dvystrcil/vt350/notes/status.md

# Build status: read this first when picking the project back up

Last updated **2026-11-04**.

## What this printer is

A Voron Trident 350 derivative on a **4040 frame**: MGN12 rails on X/Y, three
MGN9 rails on Z with integrated-leadscrew NEMA17s (T8, 8 mm), 250 mm Z travel,
**MadMax toolchanger** with two toolheads (A4T + Dragon Rapido UHF, Orbiter 2.5
+ **Orbitool O2S** + **Orbiter Smart Filament Sensor**), kinematic bed (LDO
350 plate kit, tanaes Trident mounts), Octopus Pro + Pi 5, fully enclosed.

## Decisions made

| Date | Decision | Where |
|---|---|---|
| 2026-11-10 | **Web front end: Fluidd** (Mainsail stays a one-line switch: `platform/klipper/frontend.py --use mainsail`). Firmware is Kalico; tool-change macros are MadMax's `r2pdx_config-v2-Kalico-Beacon` on klipper-toolchanger | `cad/klipper/README.md`, #116 |
| 2026-11-04 | **+100 mm between the gantry and the frame top**, for bowden/USB clearance; gantry height and Z travel unchanged | `cad/README.md` |
| 2026-11-04 | Frame bars crossing the change are **re-extruded from their end profile** (parametric), not cut-and-spliced | `cad/README.md` |
| 2026-11-04 | Door gets **3 identical hinges** | `cad/README.md` |
| 2026-11-04 | Door handle stays where it is until the pack decision | #5 |
| 2026-11-04 | **Chamber target: 60 °C sustained, 70 °C peak** (revised down from 80 °C). Good for ASA/ABS; some nylons may want more, which is an accepted limit | #4 |
| 2026-11-04 | Active chamber heater; PC/PC-CF printed parts; electronics outside the chamber; motor cooling (all decided at 80 °C: **revisit** at 60 °C) | #4 |
| 2026-11-04 | 140 mm Noctua ceiling fans to push hot air down; **separate insulated roof panel** | #5 |
| 2026-11-04 | Toolheads: **Orbitool O2S + OSS**; **Nitehawk-36 not used** | #6 |
| 2026-11-09 | **lite-30**: O2S + Smart Sensor on both heads (Orbiter designer's STEP, CC0); Nitehawk-36 boxes removed; each Orbiter's motor/gear stack corrected −2.0 mm onto its hub | #6, `cad/README.md` |
| 2026-11-04 | **Go deep: +80 mm of Y at the front** (A4Tv2 + O2S head, deepest slice 68.6 mm). Backbone, Z, bed and rear frame stay; the old front verticals become Z posts | #19, `cad/README.md` (lite-6) |
| 2026-11-04 | Gantry: **LDO Monolith milled, 2WD, VT 9 mm, rear NP** (FT hits the rear gantry 2020); **MGN9 × 470 Y rails**; **Carbonara 430 CF X beam** | #11, #19 |
| 2026-11-04 | **Taller Z: gantry +50 mm in the same 740 mm frame; Z rails and lead screws 400** (~348 mm print height). The 400 integrated motor is in stock at West3D | `cad/README.md` (lite-10) |
| 2026-11-04 | **A4Tv2 needs the 3 mm spacer** between the hotend top and the shroud ceiling (confirmed by the A4Tv2's creator). The nozzle sits 3 mm lower; model it when the A4Tv2 replaces the A4T v1 | #19 |
| 2026-11-05 | **Insulation:** the 3 owned carbon-felt pads (10 mm), sealed in aluminium; roof and back outside their panels, right wall between the panel and the electronics. **Test a pad for conductivity first.** | #14 |
| 2026-11-05 | **Camera: Nocturne USB** (Luke's Lab / West3D, 96°, rated to 70 °C, which is the chamber peak with no margin) inside, top front centre; stream MJPEG (ustreamer): a Pi 5 has no H.264 encoder, and current C920s have none either | #14 |
| 2026-11-05 | **Lights: 24 V warm white, 3500–4000 K, CRI ≥ 90**, COB in aluminium channel, switched from an Octopus output; no 5 V lighting | #14 |
| 2026-11-05 | **Kinematic bed: tanaes's Trident set** (owned, West3D). The model still has his V2.4 parts, with the front pair floating; see `notes/kinematic-bed.md` | #10 |
| 2026-11-04 | **Crossbow: the all-metal (aluminium CNC) version from West3D**, DW-Tas's current design. The A4Tv2 assembly already models it. The older Crossbow in lite-14 and earlier is gone from lite-15 | #12 |
| 2026-11-04 | **A4Tv2: its creator says to modify it as needed.** Licences decide where changes go. The A4Tv2 is [CC BY-NC-SA 4.0](https://github.com/DW-Tas/A4Tv2): remixes are allowed with attribution, non-commercially, under the same licence. The MadMax plate and dock parts are GPL-3.0. The two licences don't mix, so keep any fit changes **on the MadMax plate side (GPL-3.0, like `cad/derived/`)**, and keep any A4Tv2 changes in their own CC BY-NC-SA 4.0 folder. **Correction (lite-15):** the first hole check compared the wrong holes (the extruder mounting pattern). The proper check, in lite-15, finds all three XOL carriage-screw pairs of the A4Tv2 on andrewmcgr's plate, so **the plate fits unmodified**. Open: the left head's Crossbow lever hits the left dock brackets, and the length of the upper carriage screws | #19 |

## Open decisions (blocking)

| Issue | Question |
|---|---|
| #4 | Panel material (polycarbonate vs aluminium/ACM; acrylic is marginal at the 70 °C peak) |
| #5 | **Side pack vs DOOMCube-style top pack** for the electronics; fan model and how the 70 °C peak is bounded at the ceiling (stock NF-A14 is rated to exactly 70 °C) |
| #3 | Bowden + USB routing through the new headroom, and where they exit |
| #11 | 2WD vs AWD: the model mixes both |

## Build stages (in order)

#7 frame order → #8 printed parts → #9 frame assembly → #10 Z + bed →
#11 gantry → #12 toolchanger + toolheads → #13 electronics → #14 enclosure →
#15 first power-on + calibration.

Each stage issue has an **inventory** acceptance criterion. Tick it as you
confirm which parts you already own.

## Where things are

| What | Where |
|---|---|
| Model files (not in git) | `~/Documents/VT350/`. Current working copy **`vt350-lite-22.FCStd`** (lite-19 + the re-measured rear hole row (lite-20), BTT Pad 7 screen removed (lite-21), pad cut-outs measured with calipers (lite-22); electronics in `vt350-ebox.FCStd`, same global frame); untouched original `vt350-good.FCStd` |
| **Backup of the model files** | restic to the home NAS. Run **`cad/backup-models.sh --verify`** (alias `vt350-backup`) after model changes; old snapshots are pruned automatically (last 10, daily for 30 days, monthly for a year). Target and password are local config (`~/.config/vt350/backup.env`), not in this public repo; keep the restic password in the password manager too. First backup 2026-11-04: 52 files, 4.09 GB, test restore byte-identical |
| How the model files were made + how to redo it | `cad/README.md`, `cad/passes/` |
| Cut list (draft) | `notes/cut-list.md` |
| Parts already owned + design impact | `notes/parts-owned.md` |
| Source STEP files (frame variants, toolheads, boards) | `~/Documents/VT350/` |
| FreeCAD | `~/FreeCAD/FreeCAD_26.3rc2-Linux-x86_64.AppImage`, launched from `~/Desktop/freecad-26.3rc2.desktop` (on the RTX 2070) |
| Tracking | GitHub project "3D Printer Projects"; label `build-stage` |

## Not in this repo / not done yet

- The model backup is on the home NAS, which is not off-site.
- `~/Documents/3D Files/ebox/ebox.FCStd` is **not** this printer's ebox (most
  likely the Neptune's portable power supply). The VT350 electronics are the
  `Electronics` group inside the model.
- Splitting the model into per-assembly files with `App::Link` (would make it
  lighter still).
- Klipper config (`config/`): starts in stage #15.
- Wiring documentation for the electronics (stage #13): candidate tool [WireViz](https://github.com/wireviz/WireViz). It turns wiring described in YAML into diagrams and a bill of materials, so the docs can be versioned like the rest of the repo.
