dvystrcil/vt350/notes/reference/frame-colour/fern-low_front.jpg

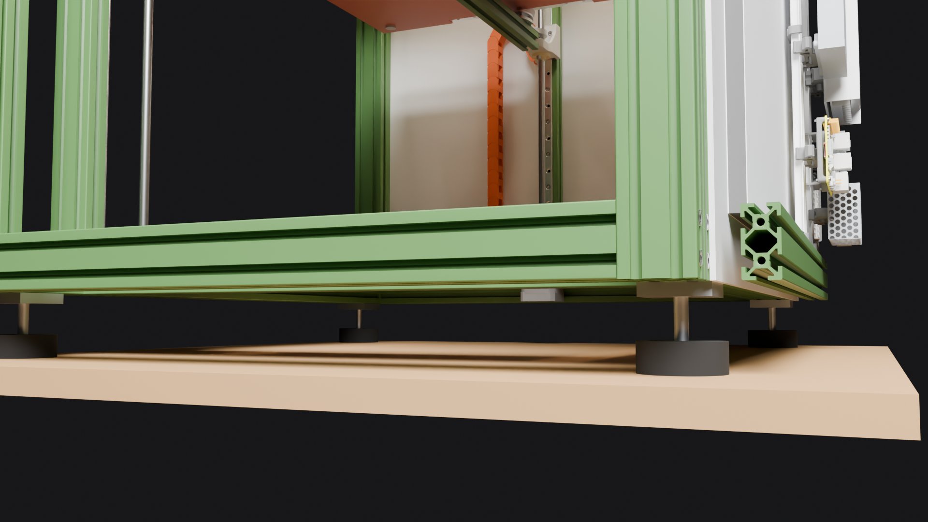
notes/reference/frame-colour/fern-low_front.jpg
