dvystrcil/vt350/notes/reference/frame-colour/fern-low_side.jpg

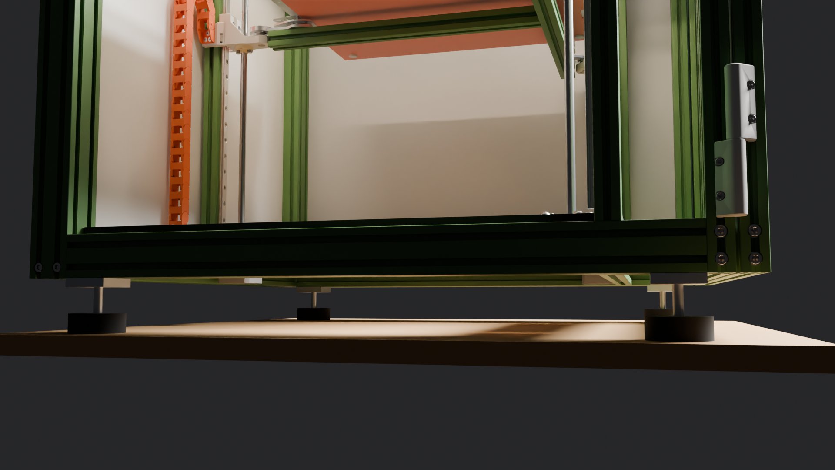
notes/reference/frame-colour/fern-low_side.jpg
