dvystrcil/vt350/notes/reference/frame-colour/r6001-low_side.jpg

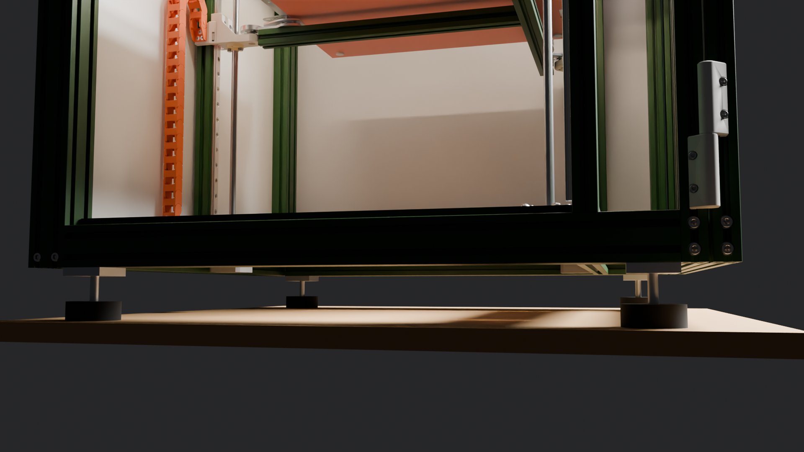
notes/reference/frame-colour/r6001-low_side.jpg
