dvystrcil/vt350/notes/reference/orbiter-hub/1_in_place.jpg

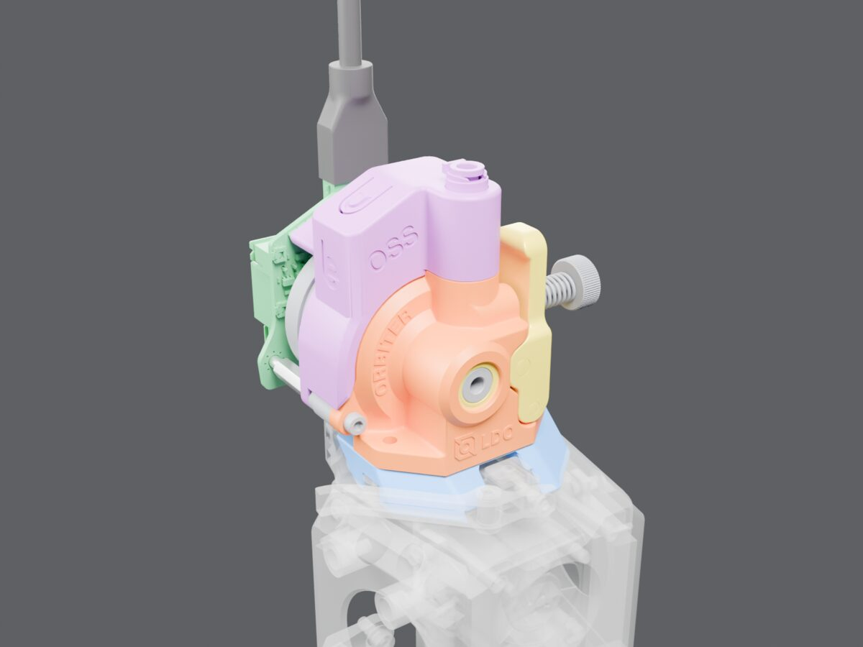
notes/reference/orbiter-hub/1_in_place.jpg
