dvystrcil/vt350/notes/reference/orbiter-hub/2_exploded.jpg

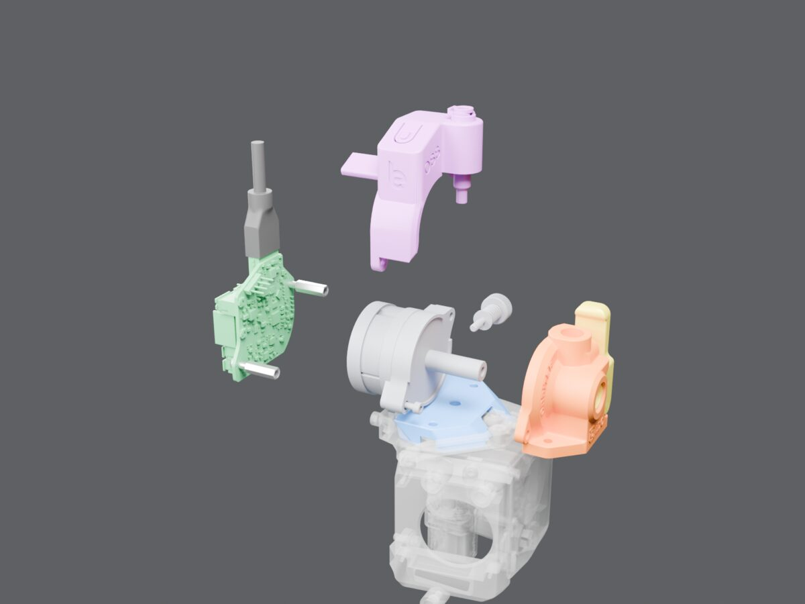
notes/reference/orbiter-hub/2_exploded.jpg
