dvystrcil/vt350/notes/reference/orbiter-hub/3_hub_closeup.jpg

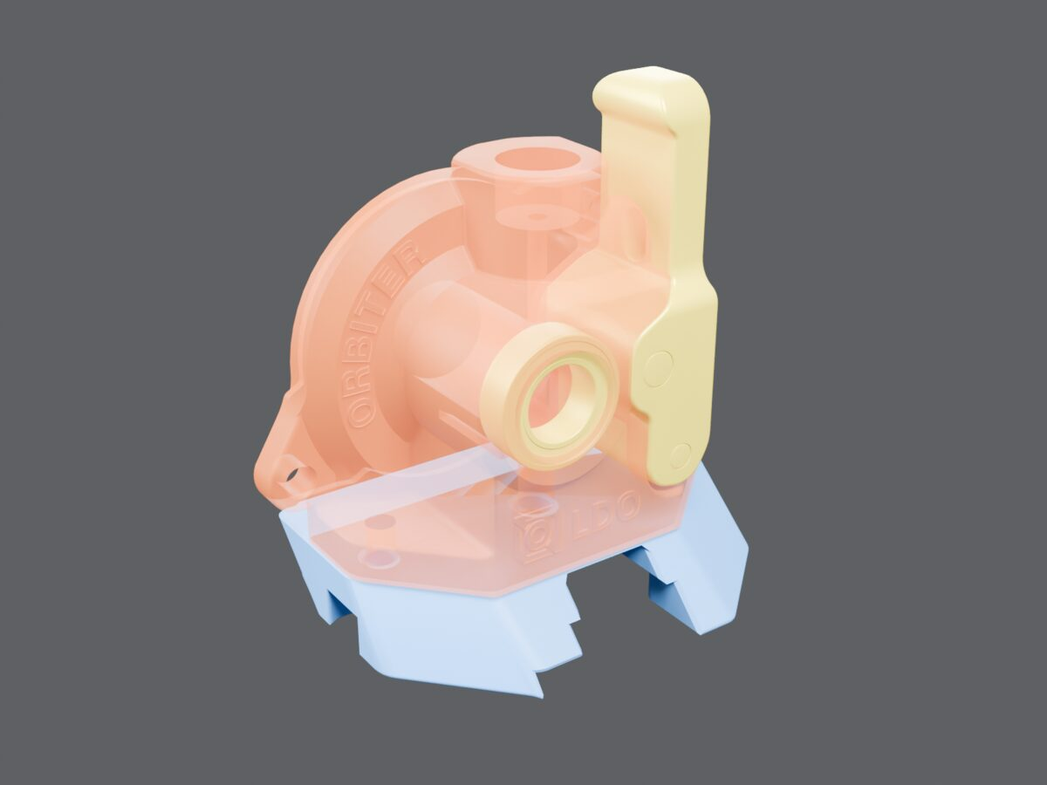
notes/reference/orbiter-hub/3_hub_closeup.jpg
