dvystrcil/vt350/notes/reference/toolchange-docks/1_t0-pickup-seq20.jpg

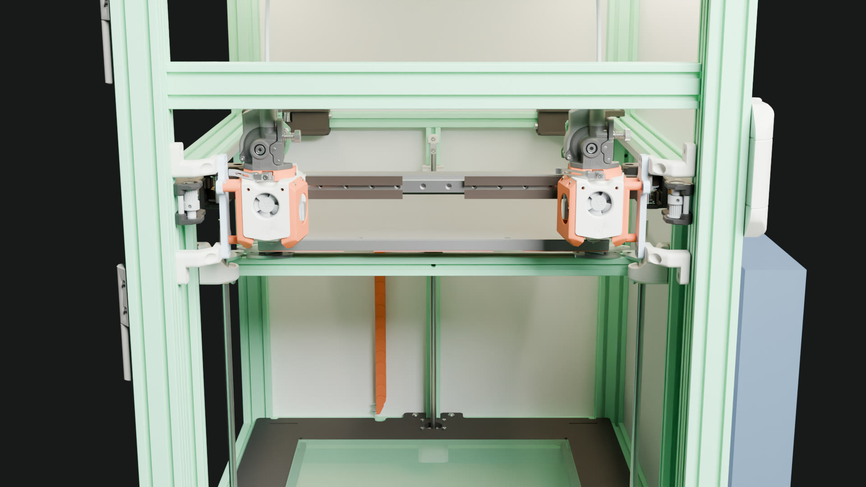
notes/reference/toolchange-docks/1_t0-pickup-seq20.jpg
