dvystrcil/vt350/parts/printed/manifest.csv

path | part | qty | stage | bom | source | repo | commit | upstream_path | sha256 | license | variant | link | material | notes
voron-trident/z_carriage_left.stl | Z carriage, left | 1 | 10 | Z_Assembly/z_carriage_left/right, [a]_z_carriage_left/right | Voron Trident R1 | VoronDesign/Voron-Trident | 86eae85057df4e3d1a07fe7eae44d6126724fe00 | STLs/Z_Assembly/z_carriage_left.stl | 81a21244a3c9f269a8c3c8a4f679dc732e6a184795a4f4e1b7f535c1d6719d2f | GPL-3.0 |  |  | chamber material (#8 AC1)
voron-trident/z_carriage_right.stl | Z carriage, right | 1 | 10 | Z_Assembly/z_carriage_left/right, [a]_z_carriage_left/right | Voron Trident R1 | VoronDesign/Voron-Trident | 86eae85057df4e3d1a07fe7eae44d6126724fe00 | STLs/Z_Assembly/z_carriage_right.stl | c2fd3f513c2ecfd7a1eec1b6bf36ac21b913ee49b1320579de19448d189f0bf1 | GPL-3.0 |  |  | chamber material (#8 AC1)
voron-trident/[a]_z_carriage_left.stl | Z carriage cover, left | 1 | 10 | Z_Assembly/z_carriage_left/right, [a]_z_carriage_left/right | Voron Trident R1 | VoronDesign/Voron-Trident | 86eae85057df4e3d1a07fe7eae44d6126724fe00 | STLs/Z_Assembly/[a]_z_carriage_left.stl | 0ee600fee7b37519e4b7689d9658e6ef2d71baa492f395a0afc1b8cb54ac64f0 | GPL-3.0 |  |  | chamber material (#8 AC1) | accent colour
voron-trident/[a]_z_carriage_right.stl | Z carriage cover, right | 1 | 10 | Z_Assembly/z_carriage_left/right, [a]_z_carriage_left/right | Voron Trident R1 | VoronDesign/Voron-Trident | 86eae85057df4e3d1a07fe7eae44d6126724fe00 | STLs/Z_Assembly/[a]_z_carriage_right.stl | e75dc5a149c4daa41c57ed505795e29d18de8bc0dd60e327afca741d4891c497 | GPL-3.0 |  |  | chamber material (#8 AC1) | accent colour
voron-trident/z_carriage_rear_2hole.stl | Z carriage, rear (2-hole chain mount) | 1 | 10 | Z_Assembly/z_carriage_rear_2hole or _3hole | Voron Trident R1 | VoronDesign/Voron-Trident | 86eae85057df4e3d1a07fe7eae44d6126724fe00 | STLs/Z_Assembly/z_carriage_rear_2hole.stl | 55990b0ba031a994f0fdc5109acb678de8c9fc44f7211c8c50861ef639529662 | GPL-3.0 | z-rear-carriage |  | chamber material (#8 AC1) | pick 2-hole or 3-hole to match the Z chain (decide, #10 AC4)
voron-trident/z_carriage_rear_3hole.stl | Z carriage, rear (3-hole chain mount) | 1 | 10 | Z_Assembly/z_carriage_rear_2hole or _3hole | Voron Trident R1 | VoronDesign/Voron-Trident | 86eae85057df4e3d1a07fe7eae44d6126724fe00 | STLs/Z_Assembly/z_carriage_rear_3hole.stl | d807725cff29aef0bf7916b9425bed76358725fab5055f5ce4e1a420d1c5eed5 | GPL-3.0 | z-rear-carriage |  | chamber material (#8 AC1) | pick 2-hole or 3-hole to match the Z chain (decide, #10 AC4)
voron-trident/[a]_z_rail_stop_x3.stl | Z rail stop | 3 | 10 | Z_Assembly/[a]_z_rail_stop_x3 | Voron Trident R1 | VoronDesign/Voron-Trident | 86eae85057df4e3d1a07fe7eae44d6126724fe00 | STLs/Z_Assembly/[a]_z_rail_stop_x3.stl | 7f3ac04062f2157999bc1e272c30512186d79f4d0beea98f3b561361f81e745f | GPL-3.0 |  |  | chamber material (#8 AC1) | accent colour
voron-trident/z_rear_extrusionbracket_left.stl | Z rear extrusion bracket, left | 1 | 10 | Z_Assembly/z_rear_extrusionbracket_left/right | Voron Trident R1 | VoronDesign/Voron-Trident | 86eae85057df4e3d1a07fe7eae44d6126724fe00 | STLs/Z_Assembly/z_rear_extrusionbracket_left.stl | c41999d78519b8dc876528f42b831bfefe86a3eaebb01540eaa775d01e120d8d | GPL-3.0 |  |  | chamber material (#8 AC1) | Monolith FAQ: rotate 180° in Full Travel mode, or plain brackets in No Protrusion mode
voron-trident/z_rear_extrusionbracket_right.stl | Z rear extrusion bracket, right | 1 | 10 | Z_Assembly/z_rear_extrusionbracket_left/right | Voron Trident R1 | VoronDesign/Voron-Trident | 86eae85057df4e3d1a07fe7eae44d6126724fe00 | STLs/Z_Assembly/z_rear_extrusionbracket_right.stl | 4c6d388cbd160d20cf52bfd7b9840c1769e1be1e2be4674368cdcb4425ae7a3f | GPL-3.0 |  |  | chamber material (#8 AC1) | Monolith FAQ: rotate 180° in Full Travel mode, or plain brackets in No Protrusion mode
voron-trident/10mm_extrusion_drill_guide.stl | Extrusion drill guide, 10 mm | 1 | 9 | Tools/10mm_extrusion_drill_guide, 140mm_extrusion_drill_guide | Voron Trident R1 | VoronDesign/Voron-Trident | 86eae85057df4e3d1a07fe7eae44d6126724fe00 | STLs/Tools/10mm_extrusion_drill_guide.stl | f30f3b0421c79b6f254c1c5f8020dcc1e69b2d147da14fd3a45785bbacabc81e | GPL-3.0 |  |  | any material (assembly jig)
voron-trident/140mm_extrusion_drill_guide.stl | Extrusion drill guide, 140 mm | 1 | 9 | Tools/10mm_extrusion_drill_guide, 140mm_extrusion_drill_guide | Voron Trident R1 | VoronDesign/Voron-Trident | 86eae85057df4e3d1a07fe7eae44d6126724fe00 | STLs/Tools/140mm_extrusion_drill_guide.stl | 453660ff6ab57c3445951c77f0ade78f5d8e1d9aad4b93afc7c9b4f1b1387fea | GPL-3.0 |  |  | any material (assembly jig)
voron-trident/MGN9_rail_guide_x2.stl | MGN9 rail guide (Z and Y rails) | 2 | 10 | Tools/MGN9_rail_guide_x2, MGN12_rail_guide_x2 | Voron Trident R1 | VoronDesign/Voron-Trident | 86eae85057df4e3d1a07fe7eae44d6126724fe00 | STLs/Tools/MGN9_rail_guide_x2.stl | bbd4cf6fc1ef3d50a0e1faacc7b5123db79ff4b8ce31f31d677df95bf49dad8d | GPL-3.0 |  |  | any material (assembly jig) | also used for the Y rails in #11
voron-trident/MGN12_rail_guide_x2.stl | MGN12 rail guide (X rail) | 2 | 11 | Tools/MGN9_rail_guide_x2, MGN12_rail_guide_x2 | Voron Trident R1 | VoronDesign/Voron-Trident | 86eae85057df4e3d1a07fe7eae44d6126724fe00 | STLs/Tools/MGN12_rail_guide_x2.stl | d56bd9b521475499ea27796228a147a4291014329d2b168abb548d686773212a | GPL-3.0 |  |  | any material (assembly jig)
ldo-monolith/Cable_management_clip_S.stl | Cable management clip, S | as-needed | 11 | LDO Monolith kit STLs | LDO Monolith kit | Monolith3D/LDO_Monolith_Gantry_Kits | 95cb5fc3957369aeb1e631f4656880bdb69ea770 | STLs/Cable_management/Cable_management_clip_S.stl | 32494dd8836d94a9dda2d26cb8de5dd0e37413373f4ed947656710a6de4614df | CC BY-NC-SA 4.0 |  |  | chamber material (#8 AC1) | quantity per the LDO manual (not stated in the repo)
ldo-monolith/Cable_management_clip_M.stl | Cable management clip, M | as-needed | 11 | LDO Monolith kit STLs | LDO Monolith kit | Monolith3D/LDO_Monolith_Gantry_Kits | 95cb5fc3957369aeb1e631f4656880bdb69ea770 | STLs/Cable_management/Cable_management_clip_M.stl | 686feace5ce71dd7da42a3276fc0d85e44de4b0c1a0d32f02f87619d942c3e18 | CC BY-NC-SA 4.0 |  |  | chamber material (#8 AC1) | quantity per the LDO manual (not stated in the repo)
ldo-monolith/Cable_management_clip_L.stl | Cable management clip, L | as-needed | 11 | LDO Monolith kit STLs | LDO Monolith kit | Monolith3D/LDO_Monolith_Gantry_Kits | 95cb5fc3957369aeb1e631f4656880bdb69ea770 | STLs/Cable_management/Cable_management_clip_L.stl | ac743b804461715d961a5531efddb836328132bf2483abc2afc7e07f6d725ef1 | CC BY-NC-SA 4.0 |  |  | chamber material (#8 AC1) | quantity per the LDO manual (not stated in the repo)
madmax/SpeedClip_4mm_Gap_9mm.stl | MadMax SpeedClip, 9 mm belts | 2 | 11 | Gantry/X_Axis/X_Carriage/* | MadMax | zruncho3d/madmax | 6bf670de9adcc5924e2fb552978161d7a9c7b1c8 | STL/SpeedClip_4mm_Gap_9mm.stl | 10d362376dc9f0ce39810f838bdd0216ccf31f945adddc696575c604f00b1b77 | GPL-3.0 |  |  | chamber material (#8 AC1)
madmax/andrewmcgr/Plate Assembly.stl | MadMax tool plate (XOL), one per head | 2 | 12 | MadMax | MadMax / andrewmcgr | zruncho3d/madmax | 6bf670de9adcc5924e2fb552978161d7a9c7b1c8 | User Mods/andrewmcgr/XOL-A4T-Cartographer/STL/Plate Assembly.stl | bf427c0e4f2fa7dfc713b465c190908d05d30d3804efeab0b01f223cd8c2d5ce | GPL-3.0 |  |  | chamber material (#8 AC1)
madmax/andrewmcgr/Plate Back.stl | MadMax tool plate back, one per head | 2 | 12 | MadMax | MadMax / andrewmcgr | zruncho3d/madmax | 6bf670de9adcc5924e2fb552978161d7a9c7b1c8 | User Mods/andrewmcgr/XOL-A4T-Cartographer/STL/Plate Back.stl | f2923ed46711539a90301a58d00a8e6f91972312301459e56eebe451b1b6fdee | GPL-3.0 |  |  | chamber material (#8 AC1)
madmax/andrewmcgr/Dock Asembly.stl | MadMax dock keyslot plate, one per dock | 2 | 12 | MadMax | MadMax / andrewmcgr | zruncho3d/madmax | 6bf670de9adcc5924e2fb552978161d7a9c7b1c8 | User Mods/andrewmcgr/XOL-A4T-Cartographer/STL/Dock Asembly.stl | 7660f9bdbe89f2e9a5c8615ff76f67651c1059c46eeaa4c9ddd0e3aa4fa6c983 | GPL-3.0 |  |  | chamber material (#8 AC1) | upstream spelling 'Asembly'
a4tv2/main-body_dragon-rapido-UHF_o2_xol.stl | A4Tv2 main body (Dragon Rapido UHF, Orbiter, XOL) | 2 | 12 | A4Tv2 | A4Tv2 | DW-Tas/A4Tv2 | 888755a97da9e1bd3062c35c914538342ef7d6f2 | STL/main_bodies/main-body_dragon-rapido-UHF_o2_xol.stl | bf1bb79c9b672eca807577d7e6f5ae64e64bb99a685265c99c1ceb4f4e2da979 | CC BY-NC-SA 4.0 |  |  | chamber material (#8 AC1)
a4tv2/[a]_orbiter-crossbow-adapter_o2_xol.stl | A4Tv2 Orbiter Crossbow adapter | 2 | 12 | A4Tv2 | A4Tv2 | DW-Tas/A4Tv2 | 888755a97da9e1bd3062c35c914538342ef7d6f2 | STL/extruder_adapters/[a]_orbiter-crossbow-adapter_o2_xol.stl | 7f25811caab55fb5dcf97d61d496cd425d741a80edac535b55f87d7d2ae03fe3 | CC BY-NC-SA 4.0 |  |  | chamber material (#8 AC1) | accent colour
a4tv2/Duct-HEF-Dragon-UHF.stl | A4Tv2 hotend-fan duct (Dragon UHF, 2510) | 2 | 12 | A4Tv2 | A4Tv2 | DW-Tas/A4Tv2 | 888755a97da9e1bd3062c35c914538342ef7d6f2 | STL/ducts/Duct-HEF-Dragon-UHF.stl | aaf80a56f96de0005d8d0da980f1046dd384f7493d45506eefe22e362d1d9110 | CC BY-NC-SA 4.0 |  |  | chamber material (#8 AC1)
a4tv2/LED_Carrier.stl | A4Tv2 LED carrier | 2 | 12 | A4Tv2 | A4Tv2 | DW-Tas/A4Tv2 | 888755a97da9e1bd3062c35c914538342ef7d6f2 | STL/led_carrier/LED_Carrier.stl | 9bc0fea88593759ee115b19a287982673e309cb9476108f99dfa0104207d99c9 | CC BY-NC-SA 4.0 |  |  | chamber material (#8 AC1)
a4tv2/[t]_LED_diffuser.stl | A4Tv2 LED diffuser | 2 | 12 | A4Tv2 | A4Tv2 | DW-Tas/A4Tv2 | 888755a97da9e1bd3062c35c914538342ef7d6f2 | STL/led_carrier/[t]_LED_diffuser.stl | e7dfcb37d65752520259b39a1312694ce6a705809ea01204765f21ee488f455e | CC BY-NC-SA 4.0 |  |  | chamber material (#8 AC1) | transparent filament ([t])
clicky-clack/Hinge-L-solid-2X.stl | Door hinge, solid part | 3 | 9 | Clicky-Clack fridge door (tanaes) | Clicky-Clack door | tanaes/whopping_Voron_mods | 62268ed817878e54d6a1186882060aa8368d4f0f | clickyclacky_door/STLs/Hinge-L-solid-2X.stl | d597ec8fda60f70a4c5c062f1cd2616dc169451abc6503c98c0487563937924d | GPL-3.0 |  |  | chamber material (#8 AC1) | ×3 for 3 hinges (upstream ships ×2)
clicky-clack/Hinge-L-sleeve-2X.stl | Door hinge, sleeve part | 3 | 9 | Clicky-Clack fridge door (tanaes) | Clicky-Clack door | tanaes/whopping_Voron_mods | 62268ed817878e54d6a1186882060aa8368d4f0f | clickyclacky_door/STLs/Hinge-L-sleeve-2X.stl | a052bb029f5758da2552417accdee0df6e23d63e6c597824625902a86340f32b | GPL-3.0 |  |  | chamber material (#8 AC1) | ×3 for 3 hinges (upstream ships ×2)
clicky-clack/Handle.stl | Door handle | 1 | 14 | Clicky-Clack fridge door (tanaes) | Clicky-Clack door | tanaes/whopping_Voron_mods | 62268ed817878e54d6a1186882060aa8368d4f0f | clickyclacky_door/STLs/Handle.stl | a2f596a1e2c64dffd3f80d2cc12171ee723ebad4b84bd4c76b107a6a2fcd0d34 | GPL-3.0 |  |  | chamber material (#8 AC1)
clicky-clack/Handle-Hinge_Top.stl | Door handle hinge, top | 1 | 14 | Clicky-Clack fridge door (tanaes) | Clicky-Clack door | tanaes/whopping_Voron_mods | 62268ed817878e54d6a1186882060aa8368d4f0f | clickyclacky_door/STLs/Handle-Hinge_Top.stl | 772ad3170575dbc6e4a1f8ef6c09c45dcd14294cd52626bd19286c2e7a8f4017 | GPL-3.0 |  |  | chamber material (#8 AC1)
clicky-clack/Handle-Hinge_Bottom.stl | Door handle hinge, bottom | 1 | 14 | Clicky-Clack fridge door (tanaes) | Clicky-Clack door | tanaes/whopping_Voron_mods | 62268ed817878e54d6a1186882060aa8368d4f0f | clickyclacky_door/STLs/Handle-Hinge_Bottom.stl | cbbb4667ca3e0c441e44c18c1c9099725028111d7f86436126764d0672c361e6 | GPL-3.0 |  |  | chamber material (#8 AC1)
clicky-clack/Latch.stl | Door latch | 1 | 14 | Clicky-Clack fridge door (tanaes) | Clicky-Clack door | tanaes/whopping_Voron_mods | 62268ed817878e54d6a1186882060aa8368d4f0f | clickyclacky_door/STLs/Latch.stl | 52aff26fe7d564f4b88791b5868cc04250f3131708a40dbc1cc4ec53261e7ca7 | GPL-3.0 |  |  | chamber material (#8 AC1)
clicky-clack/Panel_Clip.stl | Door panel clip | 1 | 14 | Clicky-Clack fridge door (tanaes) | Clicky-Clack door | tanaes/whopping_Voron_mods | 62268ed817878e54d6a1186882060aa8368d4f0f | clickyclacky_door/STLs/Panel_Clip.stl | 818d4f975891d1d4c372d1d8ae824266a056b450e219ae3ce71a2a656ff54f4c | GPL-3.0 |  |  | chamber material (#8 AC1)
 | EMU (filament unit, per lane) | as-needed | 15 | EMU | EMU | DW-Tas/EMU | 0e92ca241eb2627fab224660ef5925ee872ad0e3 |  |  | CC BY-NC-SA 4.0 |  | https://github.com/DW-Tas/EMU/tree/0e92ca241eb2627fab224660ef5925ee872ad0e3 |  | link only: parts come from EMU's own configurator and are tracked separately (#8 AC2); stage not set by any stage issue yet
vt350/madmax-andrewmcgr-carriage-beacon/MadMaxCarriage Beacon RevH pocket 9mm belts.stl | MadMax carriage, Beacon RevH pocket, 9 mm belts | 1 | 11 | Gantry/X_Axis/X_Carriage/* | vt350 remix | dvystrcil/vt350 | 88dd58e996e1f15d52dc2c0e17e67b3916b837ef | cad/derived/madmax-andrewmcgr-carriage-beacon/MadMaxCarriage Beacon RevH pocket 9mm belts.stl | faf503fc086931be40b6288263381fd2467055347f88f49ee0171dac0efa4bba | GPL-3.0 |  |  | chamber material (#8 AC1) | lite-25 (#58, PR #62); from andrewmcgr's MadMaxCarriage @6bf670d
vt350/madmax-andrewmcgr-dock-arm/Dock Arm -9.06mm.stl | MadMax dock arm, −9.06 mm | 4 | 12 | MadMax | vt350 remix | dvystrcil/vt350 | 7200b3ec192bf8a4debbf67df053c4b717d84d65 | cad/derived/madmax-andrewmcgr-dock-arm/Dock Arm -9.06mm.stl | 790882c3ef472ba29d2c67861647535e56b99847e6610dfdfdbe918248b03472 | GPL-3.0 |  |  | chamber material (#8 AC1) | lite-23 (#53); a top and a bottom arm per dock, right dock = same part turned round
vt350/a4tv2-duct-4010-madmax-dock/A4Tv2 Duct-4010-left MadMax dock.stl | A4Tv2 4010 duct with dock bosses, left | 2 | 12 | A4Tv2 | vt350 remix | dvystrcil/vt350 | 7200b3ec192bf8a4debbf67df053c4b717d84d65 | cad/derived/a4tv2-duct-4010-madmax-dock/A4Tv2 Duct-4010-left MadMax dock.stl | ed1d46c463df9c1656b3d22e0f2e2d28a19adeed11ac18f25c3f0a82053a1e2d | CC BY-NC-SA 4.0 |  |  | chamber material (#8 AC1) | lite-23 (#53); one per head. NOT YET PRINT-ORIENTED: don't print until #53 AC8 picks the orientation
vt350/a4tv2-duct-4010-madmax-dock/A4Tv2 Duct-4010-right MadMax dock.stl | A4Tv2 4010 duct with dock bosses, right | 2 | 12 | A4Tv2 | vt350 remix | dvystrcil/vt350 | 7200b3ec192bf8a4debbf67df053c4b717d84d65 | cad/derived/a4tv2-duct-4010-madmax-dock/A4Tv2 Duct-4010-right MadMax dock.stl | 67dc9f723b268da625f642f0878f4b22d66d8e95f273ffbc44b668c1ac273339 | CC BY-NC-SA 4.0 |  |  | chamber material (#8 AC1) | lite-23 (#53); one per head. NOT YET PRINT-ORIENTED: don't print until #53 AC8 picks the orientation
vt350/btt5160-base-4-middle-screws/btt5160-base-4-middle-screws.stl | BTT TMC5160T Plus base (4 middle screws) | 1 | 13 | vt350 (this repo) | vt350 remix | dvystrcil/vt350 |  |  | a708516e533f7e82961568937cd55126432395a0a28a0b936eaef5595e50149d | GPL-3.0-or-later |  |  | electronics bay: material per #4/#5 | the user's own design (Fusion 360, 2026-05-16), not from a lite-N model; STEP source beside it; check how many drivers one base holds
