dvystrcil/vt350/parts/printed/a4tv2/main-body_dragon-rapido-UHF_o2_xol.stl

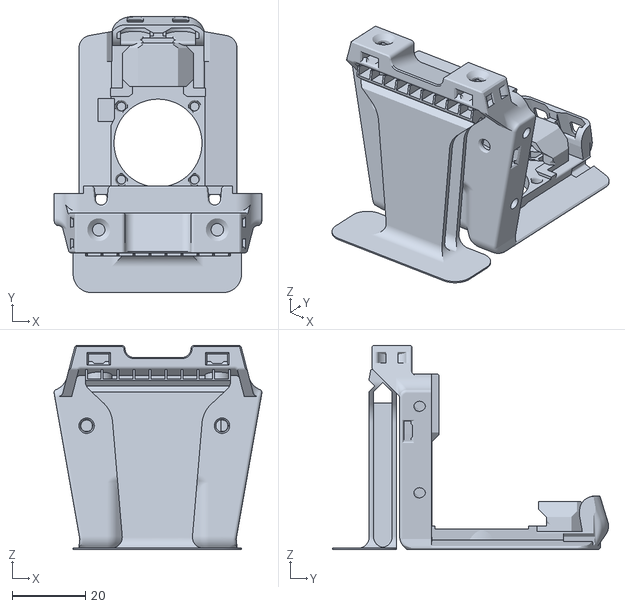
[picture p10: CAD file, 2026-11-06]
parts/printed/a4tv2/main-body_dragon-rapido-UHF_o2_xol.stl
56.8 x 75.4 x 55.8
