dvystrcil/vt350/parts/printed/madmax/andrewmcgr/Plate Assembly.stl

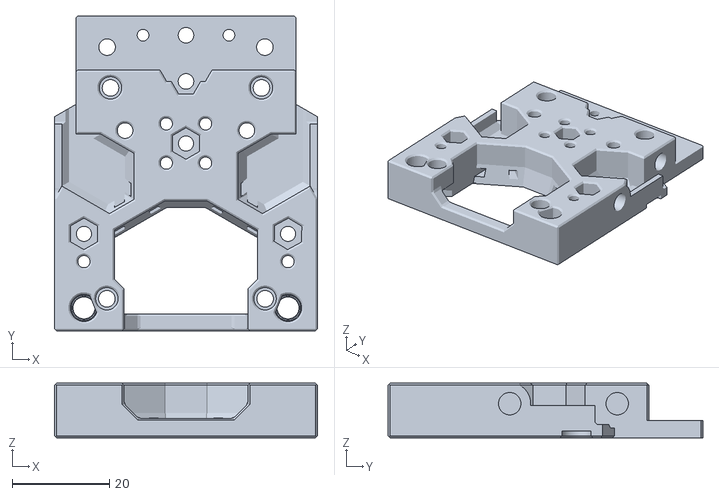
[picture p11: CAD file, 2026-11-06]
parts/printed/madmax/andrewmcgr/Plate Assembly.stl
54.0 x 64.6 x 11.2
