dvystrcil/vt350/cad/derived/madmax-andrewmcgr-carriage-beacon/MadMaxCarriage Beacon RevH pocket.stl

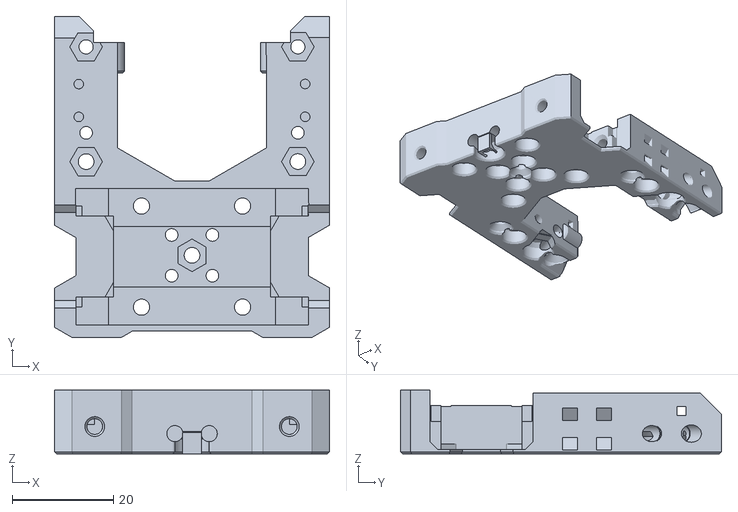
[picture p12: CAD file, 2026-11-06]
cad/derived/madmax-andrewmcgr-carriage-beacon/MadMaxCarriage Beacon RevH pocket.stl
54.4 x 63.5 x 12.6
