dvystrcil/vt350/cad/derived/madmax-andrewmcgr-dock-arm/Dock Arm +5mm.stl

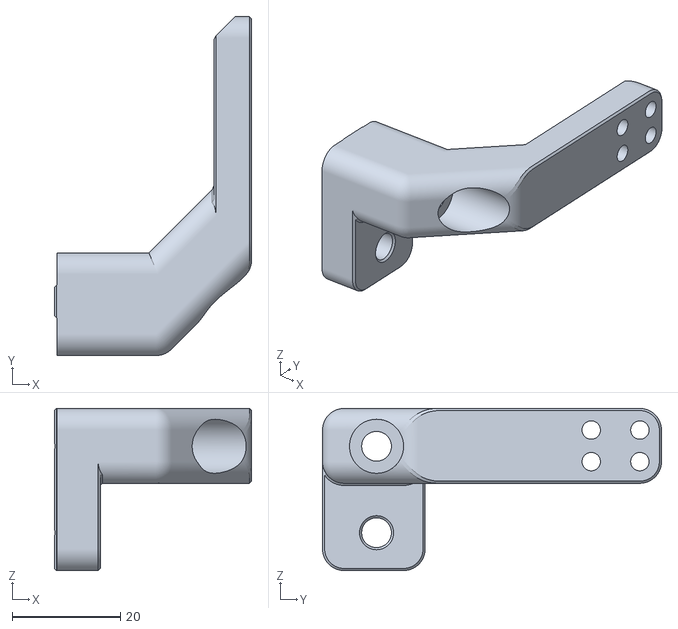
[picture p13: CAD file, 2026-11-05]
cad/derived/madmax-andrewmcgr-dock-arm/Dock Arm +5mm.stl
36.5 x 62.7 x 30.0
