dvystrcil/vt350/parts/printed/a4tv2/[t]_LED_diffuser.stl

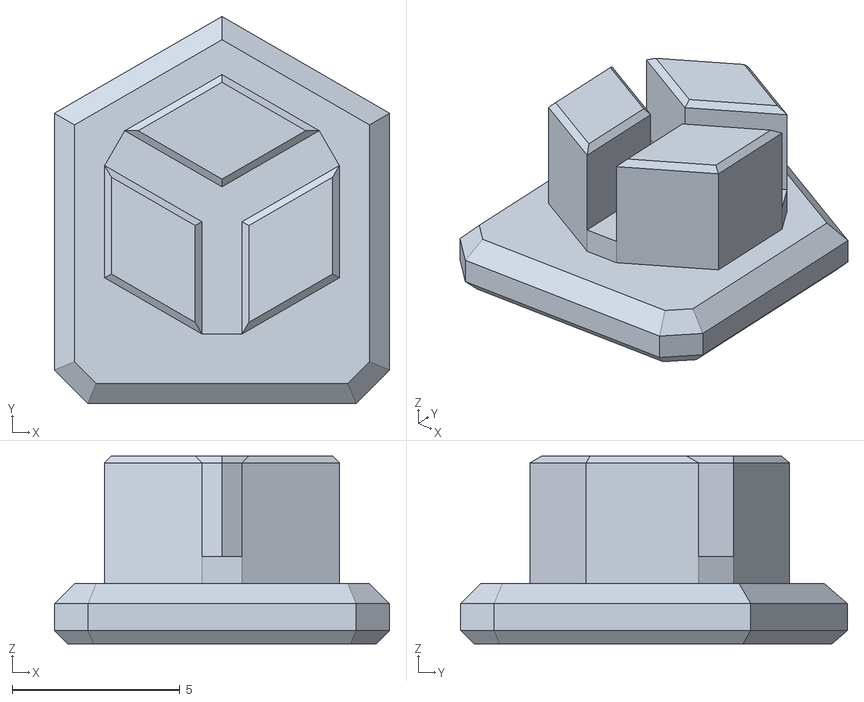
[picture p14: CAD file, 2026-11-06]
parts/printed/a4tv2/[t]_LED_diffuser.stl
10.0 x 11.5 x 5.60
