dvystrcil/vt350/parts/printed/clicky-clack/Handle.stl

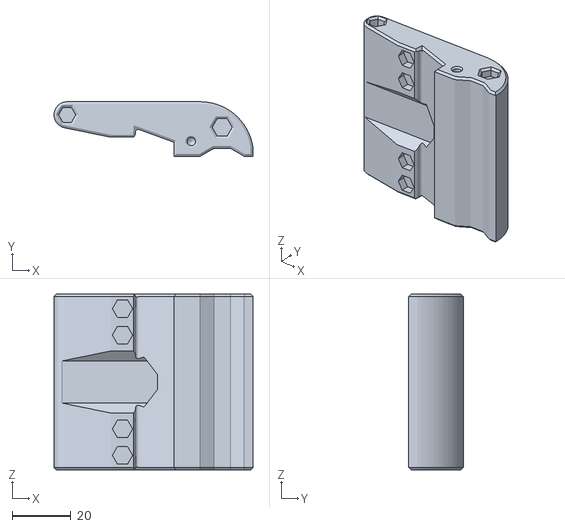
[picture p15: CAD file, 2026-11-06]
parts/printed/clicky-clack/Handle.stl
67.9 x 18.6 x 60.0
