dvystrcil/vt350/parts/printed/ldo-monolith/Cable_management_clip_S.stl

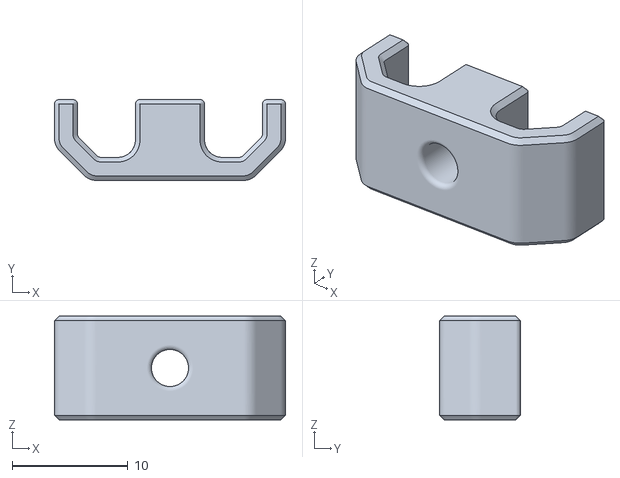
[picture p16: CAD file, 2026-11-06]
parts/printed/ldo-monolith/Cable_management_clip_S.stl
20.0 x 7.00 x 9.00
