dvystrcil/vt350/parts/printed/madmax/andrewmcgr/Dock Asembly.stl

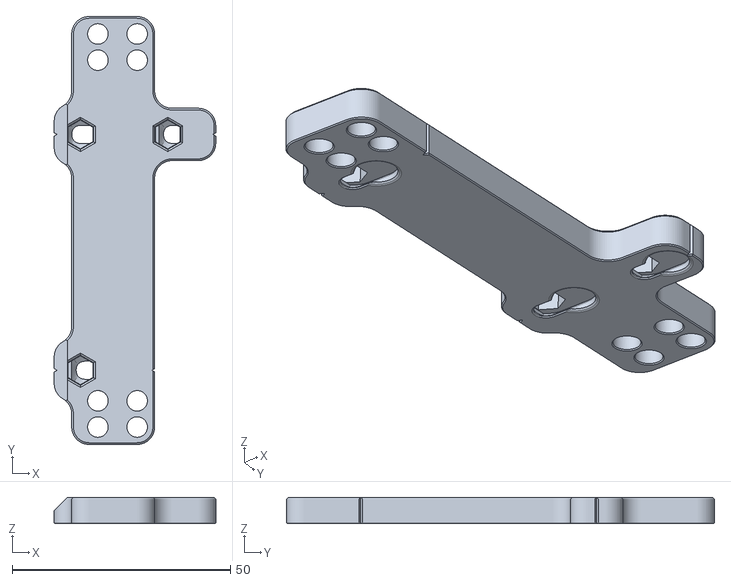
[picture p17: CAD file, 2026-11-06]
parts/printed/madmax/andrewmcgr/Dock Asembly.stl
37.0 x 98.0 x 6.00
