dvystrcil/vt350/parts/printed/madmax/SpeedClip_4mm_Gap_9mm.stl

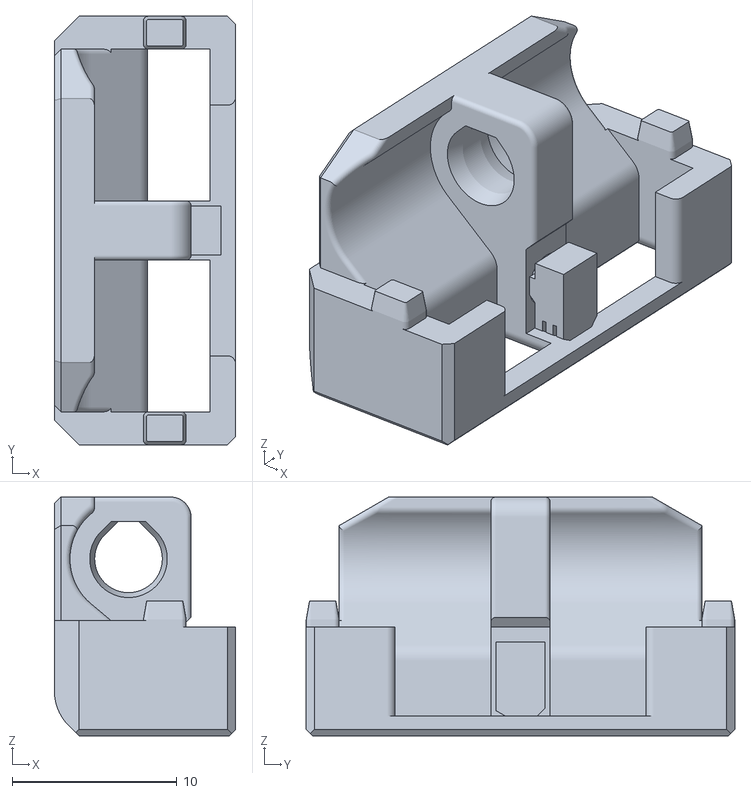
[picture p18: CAD file, 2026-11-06]
parts/printed/madmax/SpeedClip_4mm_Gap_9mm.stl
11.0 x 26.0 x 14.5
