dvystrcil/vt350/parts/printed/voron-trident/z_rear_extrusionbracket_right.stl

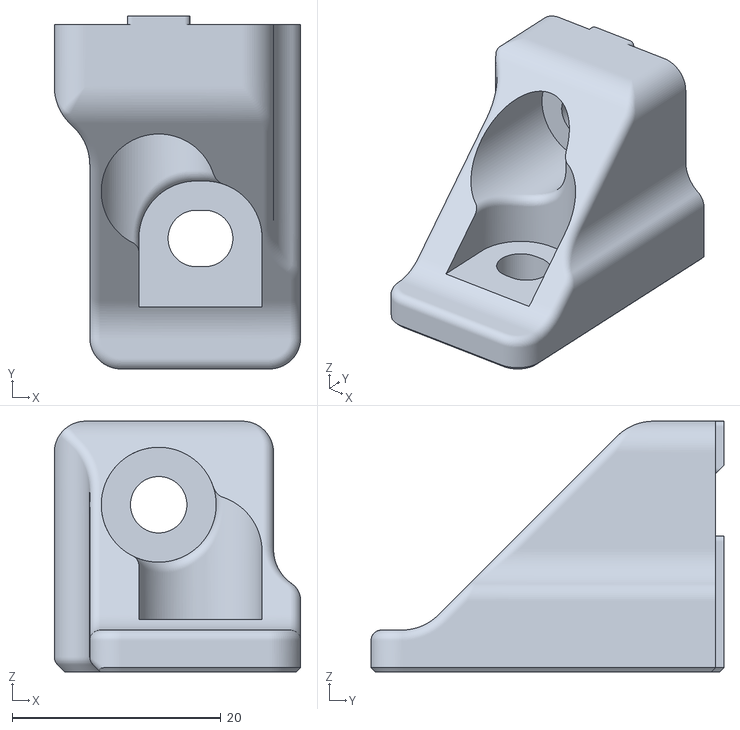
[picture p19: CAD file, 2026-11-06]
parts/printed/voron-trident/z_rear_extrusionbracket_right.stl
23.6 x 33.8 x 24.0
