dvystrcil/vt350/parts/printed/vt350/a4tv2-duct-4010-madmax-dock/A4Tv2 Duct-4010-left MadMax dock.stl

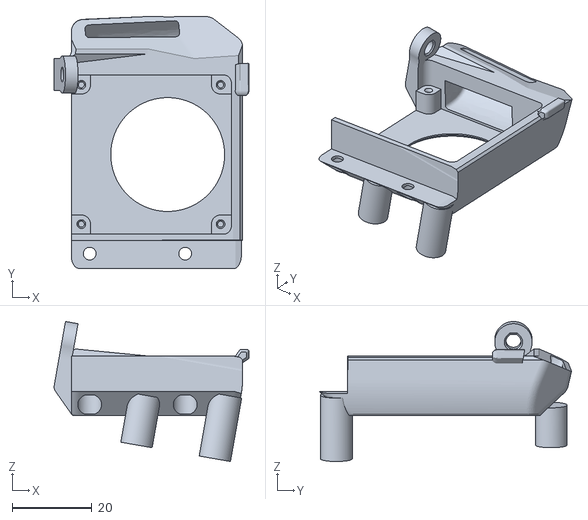
[picture p20: CAD file, 2026-11-06]
parts/printed/vt350/a4tv2-duct-4010-madmax-dock/A4Tv2 Duct-4010-left MadMax dock.stl
49.0 x 63.3 x 35.2
