dvystrcil/vt350/parts/printed/vt350/madmax-andrewmcgr-dock-arm/Dock Arm -9.06mm.stl

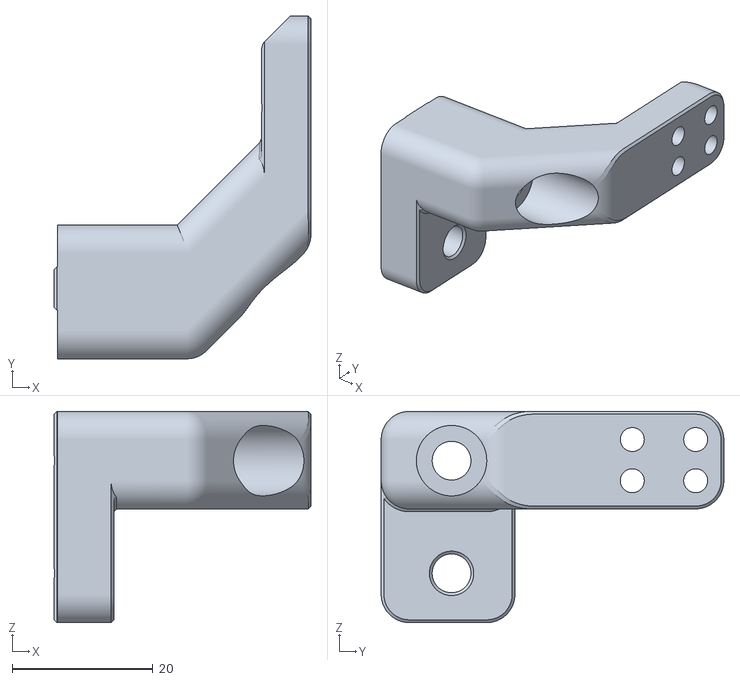
[picture p21: CAD file, 2026-11-06]
parts/printed/vt350/madmax-andrewmcgr-dock-arm/Dock Arm -9.06mm.stl
36.5 x 48.7 x 30.0
