dvystrcil/vt350/parts/printed/clicky-clack/Panel_Clip.stl

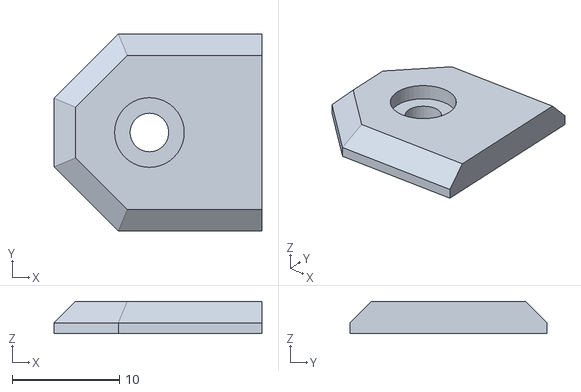
[picture p22: CAD file, 2026-11-06]
parts/printed/clicky-clack/Panel_Clip.stl
19.4 x 18.4 x 3.00
