dvystrcil/vt350/parts/printed/ldo-monolith/Cable_management_clip_L.stl

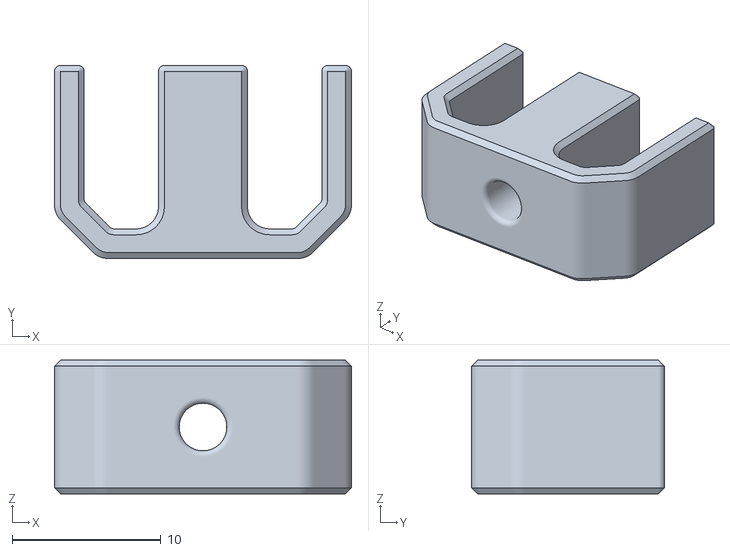
[picture p23: CAD file, 2026-11-06]
parts/printed/ldo-monolith/Cable_management_clip_L.stl
20.0 x 13.0 x 9.00
