dvystrcil/vt350/parts/printed/madmax/andrewmcgr/Plate Back.stl

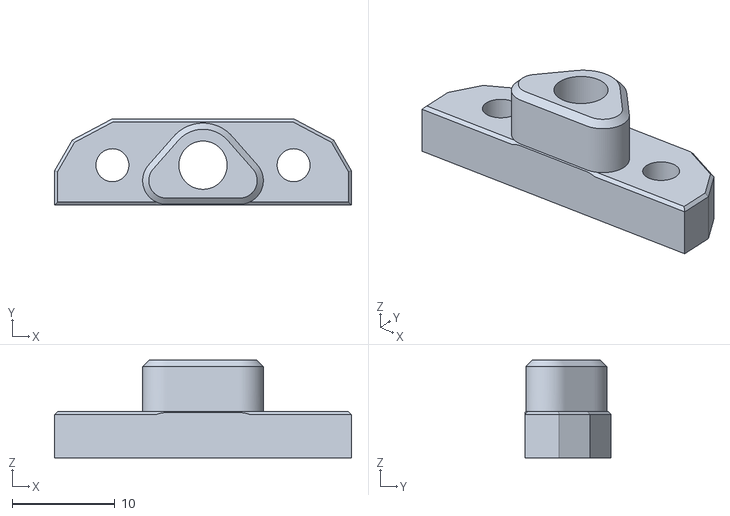
[picture p24: CAD file, 2026-11-06]
parts/printed/madmax/andrewmcgr/Plate Back.stl
28.9 x 8.42 x 9.50
