dvystrcil/vt350/parts/printed/voron-trident/z_carriage_right.stl

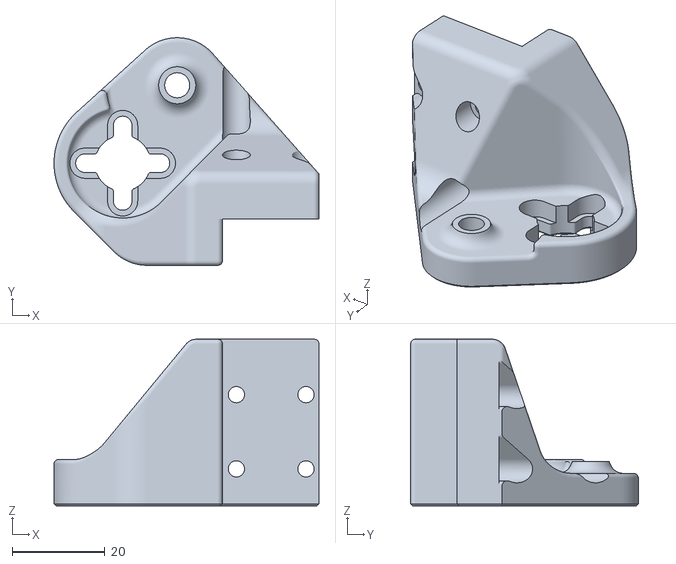
[picture p25: CAD file, 2026-11-06]
parts/printed/voron-trident/z_carriage_right.stl
57.1 x 49.1 x 35.9
