dvystrcil/vt350/parts/printed/a4tv2/Duct-HEF-Dragon-UHF.stl

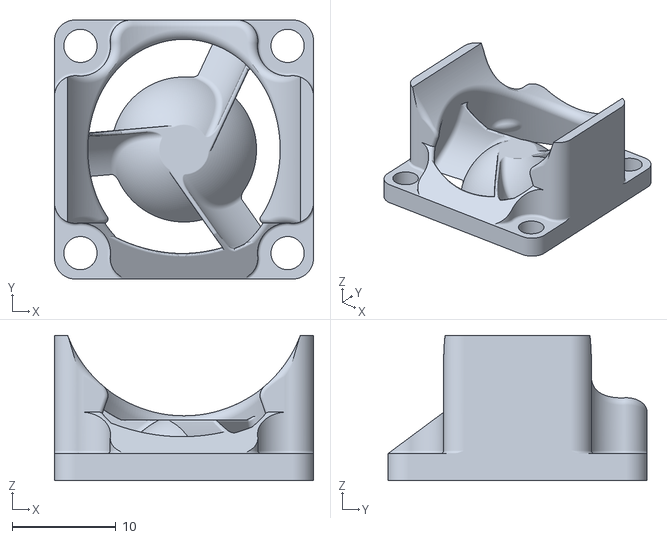
[picture p26: CAD file, 2026-11-06]
parts/printed/a4tv2/Duct-HEF-Dragon-UHF.stl
25.0 x 25.0 x 14.0
