dvystrcil/vt350/parts/printed/clicky-clack/Handle-Hinge_Bottom.stl

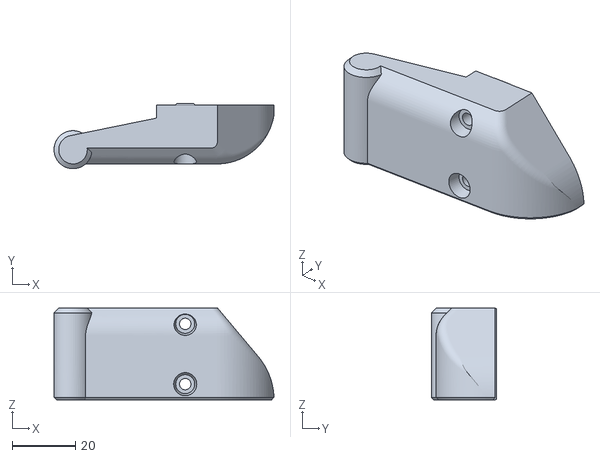
[picture p27: CAD file, 2026-11-06]
parts/printed/clicky-clack/Handle-Hinge_Bottom.stl
69.3 x 20.6 x 29.0
