dvystrcil/vt350/parts/printed/ldo-monolith/Cable_management_clip_M.stl

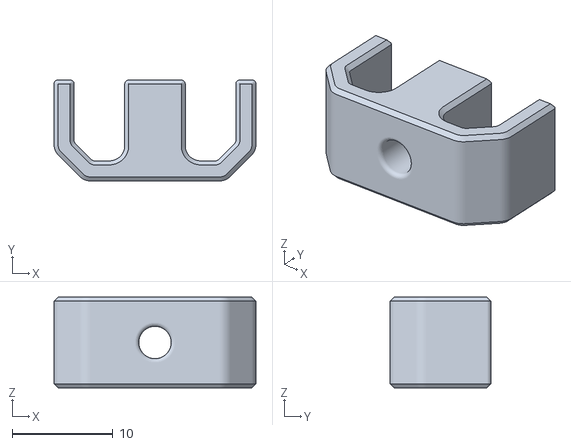
[picture p28: CAD file, 2026-11-06]
parts/printed/ldo-monolith/Cable_management_clip_M.stl
20.0 x 10.0 x 9.00
