dvystrcil/vt350/parts/printed/voron-trident/10mm_extrusion_drill_guide.stl

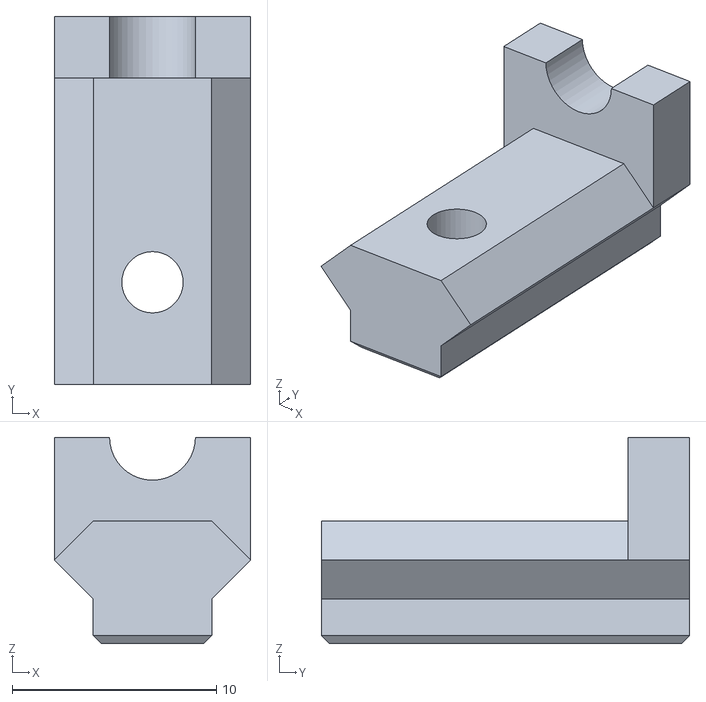
[picture p29: CAD file, 2026-11-06]
parts/printed/voron-trident/10mm_extrusion_drill_guide.stl
9.60 x 18.0 x 10.1
