dvystrcil/vt350/parts/printed/a4tv2/[a]_orbiter-crossbow-adapter_o2_xol.stl

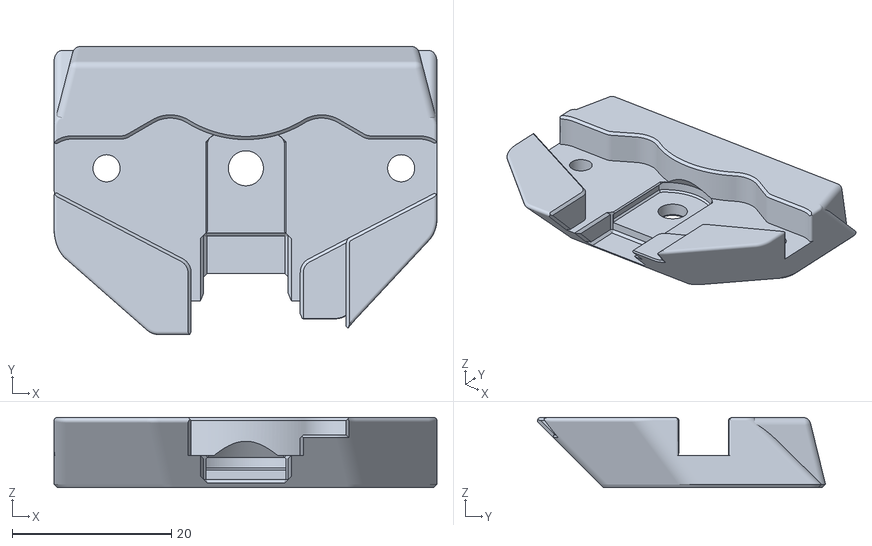
[picture p30: CAD file, 2026-11-06]
parts/printed/a4tv2/[a]_orbiter-crossbow-adapter_o2_xol.stl
48.1 x 36.2 x 8.80
