dvystrcil/vt350/parts/printed/a4tv2/LED_Carrier.stl

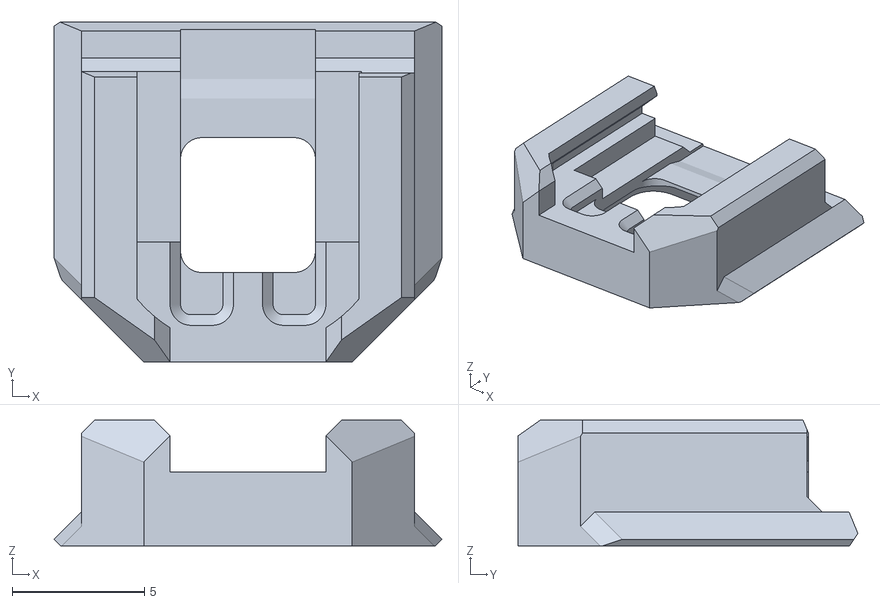
[picture p32: CAD file, 2026-11-06]
parts/printed/a4tv2/LED_Carrier.stl
14.7 x 12.9 x 4.75
