dvystrcil/vt350/parts/printed/clicky-clack/Handle-Hinge_Top.stl

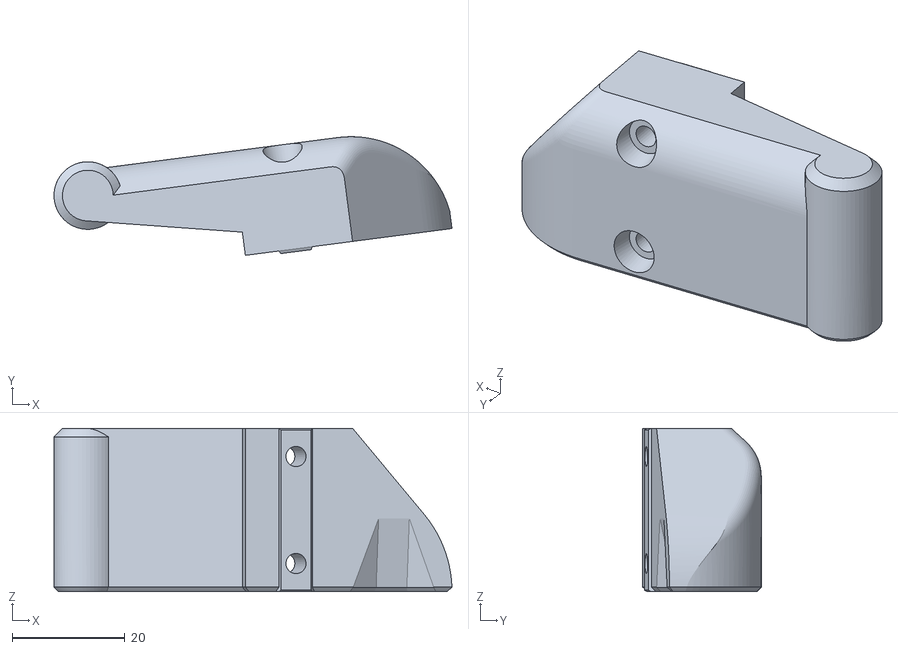
[picture p33: CAD file, 2026-11-06]
parts/printed/clicky-clack/Handle-Hinge_Top.stl
70.6 x 21.1 x 29.0
