dvystrcil/vt350/parts/printed/voron-trident/z_carriage_rear_2hole.stl

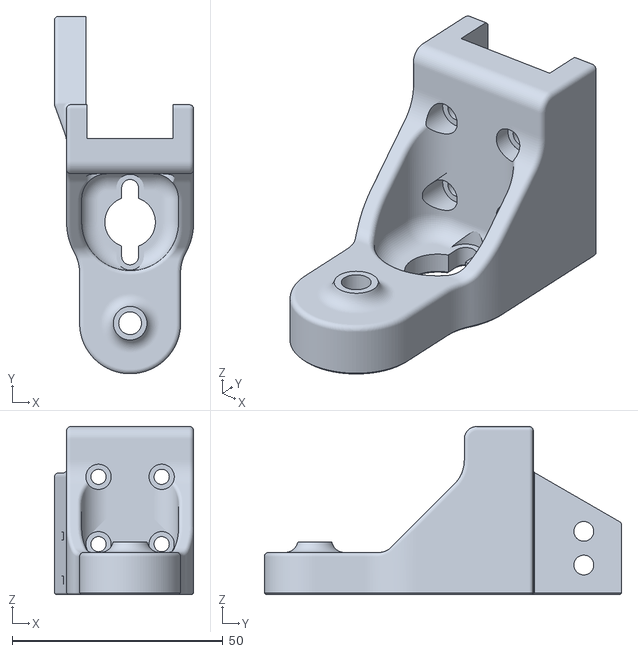
[picture p34: CAD file, 2026-11-06]
parts/printed/voron-trident/z_carriage_rear_2hole.stl
33.1 x 84.9 x 39.9
