dvystrcil/vt350/parts/printed/clicky-clack/Hinge-L-solid-2X.stl

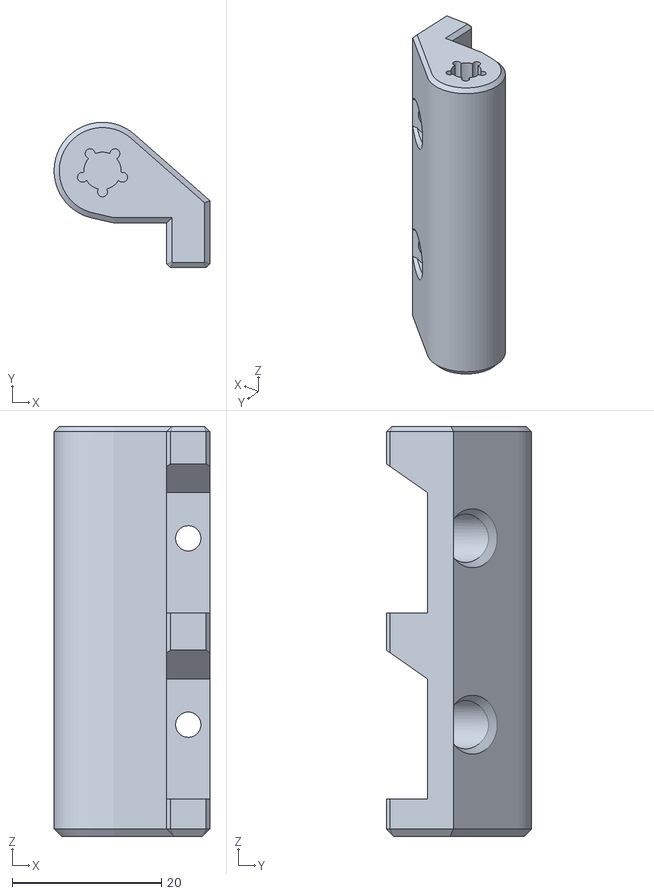
[picture p35: CAD file, 2026-11-06]
parts/printed/clicky-clack/Hinge-L-solid-2X.stl
20.9 x 19.5 x 55.0
