dvystrcil/vt350/parts/printed/voron-trident/[a]_z_rail_stop_x3.stl

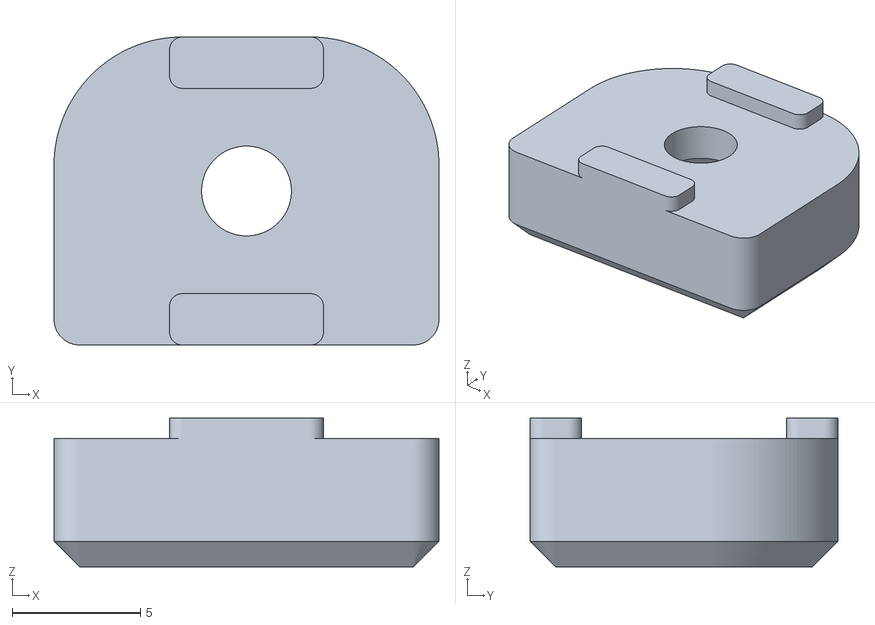
[picture p36: CAD file, 2026-11-06]
parts/printed/voron-trident/[a]_z_rail_stop_x3.stl
15.0 x 12.0 x 5.80
