dvystrcil/vt350/parts/printed/clicky-clack/Latch.stl

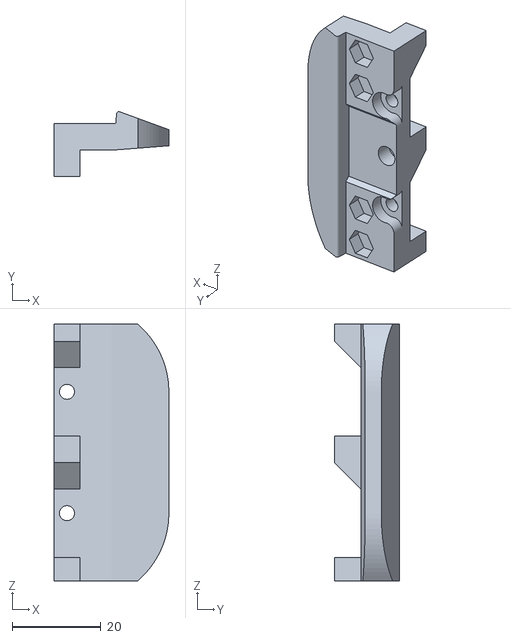
[picture p37: CAD file, 2026-11-06]
parts/printed/clicky-clack/Latch.stl
25.9 x 14.6 x 58.0
