dvystrcil/vt350/parts/printed/voron-trident/MGN12_rail_guide_x2.stl

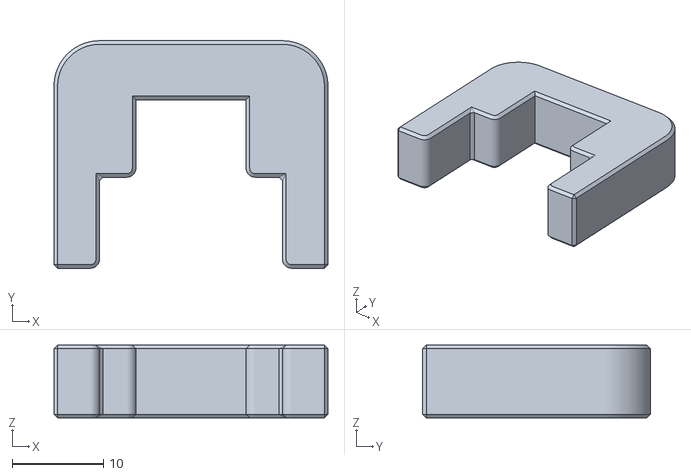
[picture p38: CAD file, 2026-11-06]
parts/printed/voron-trident/MGN12_rail_guide_x2.stl
30.1 x 25.0 x 8.00
