dvystrcil/vt350/parts/printed/voron-trident/[a]_z_carriage_right.stl

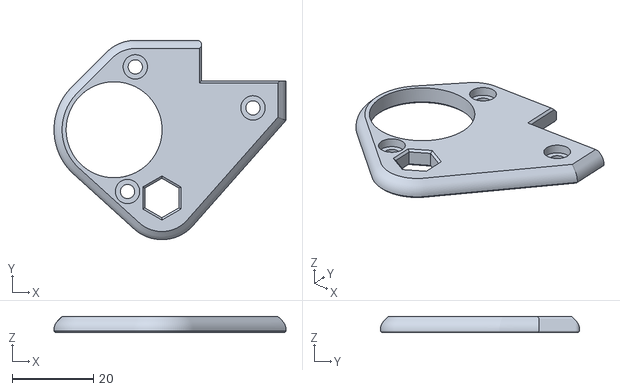
[picture p39: CAD file, 2026-11-06]
parts/printed/voron-trident/[a]_z_carriage_right.stl
57.1 x 49.0 x 4.00
