dvystrcil/vt350/parts/printed/voron-trident/MGN9_rail_guide_x2.stl

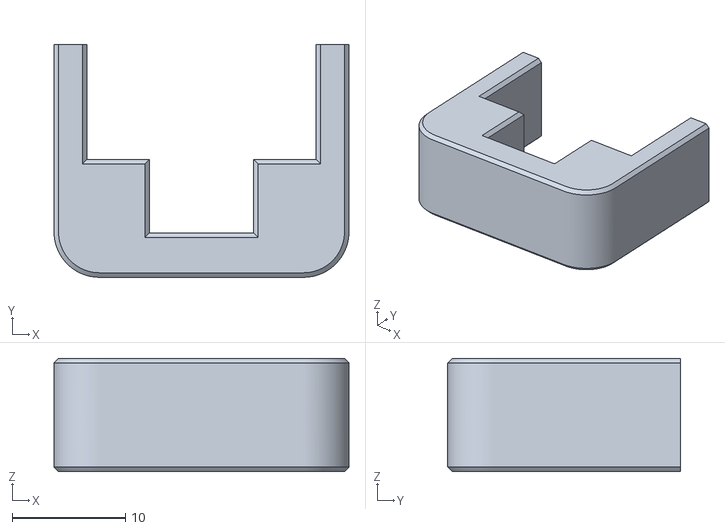
[picture p40: CAD file, 2026-11-06]
parts/printed/voron-trident/MGN9_rail_guide_x2.stl
26.0 x 20.5 x 10.0
