dvystrcil/vt350/parts/printed/voron-trident/140mm_extrusion_drill_guide.stl

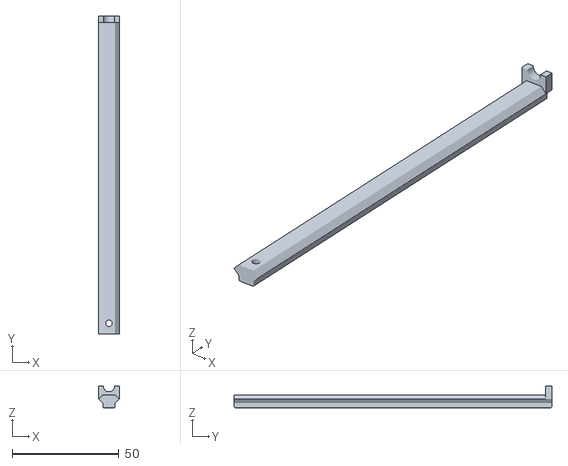
[picture p41: CAD file, 2026-11-06]
parts/printed/voron-trident/140mm_extrusion_drill_guide.stl
9.60 x 148.8 x 10.1
