dvystrcil/vt350/(list of files, cad)

Other CAD files:
parts/printed/vt350/madmax-andrewmcgr-carriage-beacon/MadMaxCarriage Beacon RevH pocket 9mm belts.stl
parts/printed/vt350/a4tv2-duct-4010-madmax-dock/A4Tv2 Duct-4010-right MadMax dock.stl
parts/printed/voron-trident/z_carriage_left.stl
parts/printed/voron-trident/z_carriage_rear_3hole.stl
parts/printed/voron-trident/[a]_z_carriage_left.stl
parts/printed/voron-trident/z_rear_extrusionbracket_left.stl
parts/printed/vt350/btt5160-base-4-middle-screws/btt5160-base-4-middle-screws.step
parts/printed/vt350/btt5160-base-4-middle-screws/btt5160-base-4-middle-screws.stl
