dvystrcil/vt350/parts/printed/README.md

# Printed parts: every part this build prints

One folder holds every printed part, ready to slice (#63). The list of what to print is
[`bom/printed-parts.md`](../../bom/printed-parts.md) (#8 AC2): every "print" row there is a part here, or a link
when the part isn't copied. Parts that the bought Monolith CNC kit, Trident Backbone and kinematic bed mount replace
are left out.

- **`manifest.csv`**: one row per part: file, qty, **stage** (the stage issue #7–#15 where it's installed, read by the
  docs generator in #40), source repo, pinned commit, upstream path, sha256, licence.
- **`<source>/`**: unchanged upstream files, each folder with the upstream `LICENSE` and a `README.md` (repo, commit,
  upstream paths, "our changes: none").
- **`vt350/`**: our remixes, under the licence of the part each was made from ([`vt350/README.md`](vt350/README.md)
  says which `lite-N` each comes from).

`platform/parts/check-printed.py` checks all of this in CI (sha256s, files not in the manifest, rows without a file, "print"
rows without a part, stages, licences). The table below is generated from `manifest.csv` by
`platform/parts/check-printed.py --write-index`; edit the manifest, not the table.

## Licences (#63 AC1)

Read from each upstream repository's `LICENSE` and `README.md` at the pinned commit on 2026-11-06. The repo is public
and non-commercial.

| Source | Pinned commit | Licence | Redistribute? | Attribution / conditions | Here |
|---|---|---|---|---|---|
| [Voron Trident](https://github.com/VoronDesign/Voron-Trident) | tag `VTr1` = [`86eae85`](https://github.com/VoronDesign/Voron-Trident/tree/86eae85057df4e3d1a07fe7eae44d6126724fe00) | GPL-3.0 | yes | licence text alongside, notices kept, source (upstream CAD) available | `voron-trident/` |
| [zruncho3d/madmax](https://github.com/zruncho3d/madmax) | [`6bf670d`](https://github.com/zruncho3d/madmax/tree/6bf670de9adcc5924e2fb552978161d7a9c7b1c8) | GPL-3.0 | yes | as above | `madmax/` |
| andrewmcgr's XOL-A4T-Cartographer (inside madmax, `User Mods/andrewmcgr/`) | same | GPL-3.0 (the repository's; the mod has no licence file of its own) | yes | as above; credit andrewmcgr | `madmax/andrewmcgr/`, remixes in `vt350/` |
| [DW-Tas/A4Tv2](https://github.com/DW-Tas/A4Tv2) (the build's toolhead since lite-15) | [`888755a`](https://github.com/DW-Tas/A4Tv2/tree/888755a97da9e1bd3062c35c914538342ef7d6f2) | CC BY-NC-SA 4.0 | yes, non-commercial | credit DW-Tas, link the licence, say what changed; adaptations under the same licence. README: NC means "A4Tv2 is the product", not printers that use it | `a4tv2/`, duct remix in `vt350/` |
| [Armchair-Heavy-Industries/A4T](https://github.com/Armchair-Heavy-Industries/A4T) (v1, replaced by A4Tv2) | [`d675d35`](https://github.com/Armchair-Heavy-Industries/A4T/tree/d675d3518c5a6213bb0d9dcc7380bbf9342066df) | CC BY-NC-SA 4.0 | yes, non-commercial | as A4Tv2 | not printed |
| [Monolith3D/LDO_Monolith_Gantry_Kits](https://github.com/Monolith3D/LDO_Monolith_Gantry_Kits) | [`95cb5fc`](https://github.com/Monolith3D/LDO_Monolith_Gantry_Kits/tree/95cb5fc3957369aeb1e631f4656880bdb69ea770) | CC BY-NC-SA 4.0 | yes, non-commercial | credit Monolith3D, link the licence, same licence for adaptations | `ldo-monolith/` |
| [Monolith3D/Toolheads_for_Monolith](https://github.com/Monolith3D/Toolheads_for_Monolith) | [`e205bff`](https://github.com/Monolith3D/Toolheads_for_Monolith/tree/e205bff37e405bfbeb40fe2d8f46dbeda45c7b73) | GPL-3.0; README: "Geometry and designs from other projects, including their derivatives, remain subject to their original licenses" | yes (check each part's origin) | as GPL-3.0 | not printed: its belt clamp is still "decide" |
| [DW-Tas/EMU](https://github.com/DW-Tas/EMU) | [`0e92ca2`](https://github.com/DW-Tas/EMU/tree/0e92ca241eb2627fab224660ef5925ee872ad0e3) | CC BY-NC-SA 4.0 | yes, non-commercial | as A4Tv2 | link only: its parts come from its own configurator, tracked separately |
| [tanaes/whopping_Voron_mods](https://github.com/tanaes/whopping_Voron_mods) (Clicky-Clack door) | [`62268ed`](https://github.com/tanaes/whopping_Voron_mods/tree/62268ed817878e54d6a1186882060aa8368d4f0f) | GPL-3.0 | yes | as GPL-3.0 | `clicky-clack/` |
| this repo (the user's BTT 5160 base) | — | GPL-3.0-or-later (the root `LICENSE`) | yes | — | `vt350/btt5160-base-4-middle-screws/` |

Every source in `bom/printed-parts.md` allows redistribution, so nothing is link-only for licence reasons. The EMU is
link-only because its part list isn't chosen yet.

## Index (#63 AC5)

<!-- BEGIN GENERATED by platform/parts/check-printed.py --write-index: do not edit by hand -->

| Part | Qty | Stage | Source | Licence | Material / print notes | File |
|---|---|---|---|---|---|---|
| Door hinge, sleeve part | 3 | #9 | Clicky-Clack door | GPL-3.0 | chamber material (#8 AC1); ×3 for 3 hinges (upstream ships ×2) | [`clicky-clack/Hinge-L-sleeve-2X.stl`](clicky-clack/Hinge-L-sleeve-2X.stl) |
| Door hinge, solid part | 3 | #9 | Clicky-Clack door | GPL-3.0 | chamber material (#8 AC1); ×3 for 3 hinges (upstream ships ×2) | [`clicky-clack/Hinge-L-solid-2X.stl`](clicky-clack/Hinge-L-solid-2X.stl) |
| Extrusion drill guide, 10 mm | 1 | #9 | Voron Trident R1 | GPL-3.0 | any material (assembly jig) | [`voron-trident/10mm_extrusion_drill_guide.stl`](voron-trident/10mm_extrusion_drill_guide.stl) |
| Extrusion drill guide, 140 mm | 1 | #9 | Voron Trident R1 | GPL-3.0 | any material (assembly jig) | [`voron-trident/140mm_extrusion_drill_guide.stl`](voron-trident/140mm_extrusion_drill_guide.stl) |
| MGN9 rail guide (Z and Y rails) | 2 | #10 | Voron Trident R1 | GPL-3.0 | any material (assembly jig); also used for the Y rails in #11 | [`voron-trident/MGN9_rail_guide_x2.stl`](voron-trident/MGN9_rail_guide_x2.stl) |
| Z carriage cover, left | 1 | #10 | Voron Trident R1 | GPL-3.0 | chamber material (#8 AC1); accent colour | [`voron-trident/[a]_z_carriage_left.stl`](voron-trident/%5Ba%5D_z_carriage_left.stl) |
| Z carriage cover, right | 1 | #10 | Voron Trident R1 | GPL-3.0 | chamber material (#8 AC1); accent colour | [`voron-trident/[a]_z_carriage_right.stl`](voron-trident/%5Ba%5D_z_carriage_right.stl) |
| Z carriage, left | 1 | #10 | Voron Trident R1 | GPL-3.0 | chamber material (#8 AC1) | [`voron-trident/z_carriage_left.stl`](voron-trident/z_carriage_left.stl) |
| Z carriage, rear (2-hole chain mount) | 1 | #10 | Voron Trident R1 | GPL-3.0 | chamber material (#8 AC1); pick 2-hole or 3-hole to match the Z chain (decide, #10 AC4); alternative: z-rear-carriage | [`voron-trident/z_carriage_rear_2hole.stl`](voron-trident/z_carriage_rear_2hole.stl) |
| Z carriage, rear (3-hole chain mount) | 1 | #10 | Voron Trident R1 | GPL-3.0 | chamber material (#8 AC1); pick 2-hole or 3-hole to match the Z chain (decide, #10 AC4); alternative: z-rear-carriage | [`voron-trident/z_carriage_rear_3hole.stl`](voron-trident/z_carriage_rear_3hole.stl) |
| Z carriage, right | 1 | #10 | Voron Trident R1 | GPL-3.0 | chamber material (#8 AC1) | [`voron-trident/z_carriage_right.stl`](voron-trident/z_carriage_right.stl) |
| Z rail stop | 3 | #10 | Voron Trident R1 | GPL-3.0 | chamber material (#8 AC1); accent colour | [`voron-trident/[a]_z_rail_stop_x3.stl`](voron-trident/%5Ba%5D_z_rail_stop_x3.stl) |
| Z rear extrusion bracket, left | 1 | #10 | Voron Trident R1 | GPL-3.0 | chamber material (#8 AC1); Monolith FAQ: rotate 180° in Full Travel mode, or plain brackets in No Protrusion mode | [`voron-trident/z_rear_extrusionbracket_left.stl`](voron-trident/z_rear_extrusionbracket_left.stl) |
| Z rear extrusion bracket, right | 1 | #10 | Voron Trident R1 | GPL-3.0 | chamber material (#8 AC1); Monolith FAQ: rotate 180° in Full Travel mode, or plain brackets in No Protrusion mode | [`voron-trident/z_rear_extrusionbracket_right.stl`](voron-trident/z_rear_extrusionbracket_right.stl) |
| Cable management clip, L | as-needed | #11 | LDO Monolith kit | CC BY-NC-SA 4.0 | chamber material (#8 AC1); quantity per the LDO manual (not stated in the repo) | [`ldo-monolith/Cable_management_clip_L.stl`](ldo-monolith/Cable_management_clip_L.stl) |
| Cable management clip, M | as-needed | #11 | LDO Monolith kit | CC BY-NC-SA 4.0 | chamber material (#8 AC1); quantity per the LDO manual (not stated in the repo) | [`ldo-monolith/Cable_management_clip_M.stl`](ldo-monolith/Cable_management_clip_M.stl) |
| Cable management clip, S | as-needed | #11 | LDO Monolith kit | CC BY-NC-SA 4.0 | chamber material (#8 AC1); quantity per the LDO manual (not stated in the repo) | [`ldo-monolith/Cable_management_clip_S.stl`](ldo-monolith/Cable_management_clip_S.stl) |
| MadMax SpeedClip, 9 mm belts | 2 | #11 | MadMax | GPL-3.0 | chamber material (#8 AC1) | [`madmax/SpeedClip_4mm_Gap_9mm.stl`](madmax/SpeedClip_4mm_Gap_9mm.stl) |
| MGN12 rail guide (X rail) | 2 | #11 | Voron Trident R1 | GPL-3.0 | any material (assembly jig) | [`voron-trident/MGN12_rail_guide_x2.stl`](voron-trident/MGN12_rail_guide_x2.stl) |
| MadMax carriage, Beacon RevH pocket, 9 mm belts | 1 | #11 | vt350 remix | GPL-3.0 | chamber material (#8 AC1); lite-25 (#58, PR #62); from andrewmcgr's MadMaxCarriage @6bf670d | [`vt350/madmax-andrewmcgr-carriage-beacon/MadMaxCarriage Beacon RevH pocket 9mm belts.stl`](vt350/madmax-andrewmcgr-carriage-beacon/MadMaxCarriage%20Beacon%20RevH%20pocket%209mm%20belts.stl) |
| A4Tv2 LED carrier | 2 | #12 | A4Tv2 | CC BY-NC-SA 4.0 | chamber material (#8 AC1) | [`a4tv2/LED_Carrier.stl`](a4tv2/LED_Carrier.stl) |
| A4Tv2 LED diffuser | 2 | #12 | A4Tv2 | CC BY-NC-SA 4.0 | chamber material (#8 AC1); transparent filament ([t]) | [`a4tv2/[t]_LED_diffuser.stl`](a4tv2/%5Bt%5D_LED_diffuser.stl) |
| A4Tv2 Orbiter Crossbow adapter | 2 | #12 | A4Tv2 | CC BY-NC-SA 4.0 | chamber material (#8 AC1); accent colour | [`a4tv2/[a]_orbiter-crossbow-adapter_o2_xol.stl`](a4tv2/%5Ba%5D_orbiter-crossbow-adapter_o2_xol.stl) |
| A4Tv2 hotend-fan duct (Dragon UHF, 2510) | 2 | #12 | A4Tv2 | CC BY-NC-SA 4.0 | chamber material (#8 AC1) | [`a4tv2/Duct-HEF-Dragon-UHF.stl`](a4tv2/Duct-HEF-Dragon-UHF.stl) |
| A4Tv2 main body (Dragon Rapido UHF, Orbiter, XOL) | 2 | #12 | A4Tv2 | CC BY-NC-SA 4.0 | chamber material (#8 AC1) | [`a4tv2/main-body_dragon-rapido-UHF_o2_xol.stl`](a4tv2/main-body_dragon-rapido-UHF_o2_xol.stl) |
| MadMax dock keyslot plate, one per dock | 2 | #12 | MadMax / andrewmcgr | GPL-3.0 | chamber material (#8 AC1); upstream spelling 'Asembly' | [`madmax/andrewmcgr/Dock Asembly.stl`](madmax/andrewmcgr/Dock%20Asembly.stl) |
| MadMax tool plate (XOL), one per head | 2 | #12 | MadMax / andrewmcgr | GPL-3.0 | chamber material (#8 AC1) | [`madmax/andrewmcgr/Plate Assembly.stl`](madmax/andrewmcgr/Plate%20Assembly.stl) |
| MadMax tool plate back, one per head | 2 | #12 | MadMax / andrewmcgr | GPL-3.0 | chamber material (#8 AC1) | [`madmax/andrewmcgr/Plate Back.stl`](madmax/andrewmcgr/Plate%20Back.stl) |
| A4Tv2 4010 duct with dock bosses, left | 2 | #12 | vt350 remix | CC BY-NC-SA 4.0 | chamber material (#8 AC1); lite-23 (#53); one per head. NOT YET PRINT-ORIENTED: don't print until #53 AC8 picks the orientation | [`vt350/a4tv2-duct-4010-madmax-dock/A4Tv2 Duct-4010-left MadMax dock.stl`](vt350/a4tv2-duct-4010-madmax-dock/A4Tv2%20Duct-4010-left%20MadMax%20dock.stl) |
| A4Tv2 4010 duct with dock bosses, right | 2 | #12 | vt350 remix | CC BY-NC-SA 4.0 | chamber material (#8 AC1); lite-23 (#53); one per head. NOT YET PRINT-ORIENTED: don't print until #53 AC8 picks the orientation | [`vt350/a4tv2-duct-4010-madmax-dock/A4Tv2 Duct-4010-right MadMax dock.stl`](vt350/a4tv2-duct-4010-madmax-dock/A4Tv2%20Duct-4010-right%20MadMax%20dock.stl) |
| MadMax dock arm, −9.06 mm | 4 | #12 | vt350 remix | GPL-3.0 | chamber material (#8 AC1); lite-23 (#53); a top and a bottom arm per dock, right dock = same part turned round | [`vt350/madmax-andrewmcgr-dock-arm/Dock Arm -9.06mm.stl`](vt350/madmax-andrewmcgr-dock-arm/Dock%20Arm%20-9.06mm.stl) |
| BTT TMC5160T Plus base (4 middle screws) | 1 | #13 | vt350 remix | GPL-3.0-or-later | electronics bay: material per #4/#5; the user's own design (Fusion 360, 2026-05-16), not from a lite-N model; STEP source beside it; check how many drivers one base holds | [`vt350/btt5160-base-4-middle-screws/btt5160-base-4-middle-screws.stl`](vt350/btt5160-base-4-middle-screws/btt5160-base-4-middle-screws.stl) |
| Door handle | 1 | #14 | Clicky-Clack door | GPL-3.0 | chamber material (#8 AC1) | [`clicky-clack/Handle.stl`](clicky-clack/Handle.stl) |
| Door handle hinge, bottom | 1 | #14 | Clicky-Clack door | GPL-3.0 | chamber material (#8 AC1) | [`clicky-clack/Handle-Hinge_Bottom.stl`](clicky-clack/Handle-Hinge_Bottom.stl) |
| Door handle hinge, top | 1 | #14 | Clicky-Clack door | GPL-3.0 | chamber material (#8 AC1) | [`clicky-clack/Handle-Hinge_Top.stl`](clicky-clack/Handle-Hinge_Top.stl) |
| Door latch | 1 | #14 | Clicky-Clack door | GPL-3.0 | chamber material (#8 AC1) | [`clicky-clack/Latch.stl`](clicky-clack/Latch.stl) |
| Door panel clip | 1 | #14 | Clicky-Clack door | GPL-3.0 | chamber material (#8 AC1) | [`clicky-clack/Panel_Clip.stl`](clicky-clack/Panel_Clip.stl) |
| EMU (filament unit, per lane) | as-needed | #15 | EMU | CC BY-NC-SA 4.0 | link only: parts come from EMU's own configurator and are tracked separately (#8 AC2); stage not set by any stage issue yet | link only: [upstream](https://github.com/DW-Tas/EMU/tree/0e92ca241eb2627fab224660ef5925ee872ad0e3) |

**Full set:** 55 printed pieces from 36 files, plus 3 file(s) printed as needed. 1 part(s) are links only, not counted. Rows marked *alternative* are pick-one: one of each group is counted.

<!-- END GENERATED -->
