dvystrcil/vt350/parts/printed/clicky-clack/README.md

# Clicky-Clack fridge door

Copied **unchanged** from [tanaes/whopping_Voron_mods](https://github.com/tanaes/whopping_Voron_mods) at commit [`62268ed`](https://github.com/tanaes/whopping_Voron_mods/tree/62268ed817878e54d6a1186882060aa8368d4f0f). By tanaes.

**Licence:** **GPL-3.0** (the upstream repository's `LICENSE`, copied here unchanged). Redistribution is allowed, including of modified versions, under the same licence. It requires: the licence text alongside, the copyright and licence notices kept, and the corresponding source available. For a printed part the source is the upstream CAD, which stays at the pinned commit linked below.

From the `clickyclacky_door/` folder. This build has **3 hinges** (#9 AC4), so the two hinge parts are printed ×3, not the ×2 in their file names. Upstream: "Parts should be oriented correctly in the STLs." Its CAD is `clickyclacky_door/CAD/clickyclackydoor v14.f3d`.

| File here | Upstream path at the pinned commit | Qty | Our changes |
|---|---|---|---|
| `Hinge-L-solid-2X.stl` | [`clickyclacky_door/STLs/Hinge-L-solid-2X.stl`](https://github.com/tanaes/whopping_Voron_mods/blob/62268ed817878e54d6a1186882060aa8368d4f0f/clickyclacky_door/STLs/Hinge-L-solid-2X.stl) | 3 | none |
| `Hinge-L-sleeve-2X.stl` | [`clickyclacky_door/STLs/Hinge-L-sleeve-2X.stl`](https://github.com/tanaes/whopping_Voron_mods/blob/62268ed817878e54d6a1186882060aa8368d4f0f/clickyclacky_door/STLs/Hinge-L-sleeve-2X.stl) | 3 | none |
| `Handle.stl` | [`clickyclacky_door/STLs/Handle.stl`](https://github.com/tanaes/whopping_Voron_mods/blob/62268ed817878e54d6a1186882060aa8368d4f0f/clickyclacky_door/STLs/Handle.stl) | 1 | none |
| `Handle-Hinge_Top.stl` | [`clickyclacky_door/STLs/Handle-Hinge_Top.stl`](https://github.com/tanaes/whopping_Voron_mods/blob/62268ed817878e54d6a1186882060aa8368d4f0f/clickyclacky_door/STLs/Handle-Hinge_Top.stl) | 1 | none |
| `Handle-Hinge_Bottom.stl` | [`clickyclacky_door/STLs/Handle-Hinge_Bottom.stl`](https://github.com/tanaes/whopping_Voron_mods/blob/62268ed817878e54d6a1186882060aa8368d4f0f/clickyclacky_door/STLs/Handle-Hinge_Bottom.stl) | 1 | none |
| `Latch.stl` | [`clickyclacky_door/STLs/Latch.stl`](https://github.com/tanaes/whopping_Voron_mods/blob/62268ed817878e54d6a1186882060aa8368d4f0f/clickyclacky_door/STLs/Latch.stl) | 1 | none |
| `Panel_Clip.stl` | [`clickyclacky_door/STLs/Panel_Clip.stl`](https://github.com/tanaes/whopping_Voron_mods/blob/62268ed817878e54d6a1186882060aa8368d4f0f/clickyclacky_door/STLs/Panel_Clip.stl) | 1 | none |

Each file's sha256 is in `../manifest.csv`; `platform/parts/check-printed.py --upstream` re-downloads every file at its commit and compares.
