dvystrcil/vt350/parts/printed/ldo-monolith/README.md

# LDO Monolith gantry kit printed parts

Copied **unchanged** from [Monolith3D/LDO_Monolith_Gantry_Kits](https://github.com/Monolith3D/LDO_Monolith_Gantry_Kits) at commit [`95cb5fc`](https://github.com/Monolith3D/LDO_Monolith_Gantry_Kits/tree/95cb5fc3957369aeb1e631f4656880bdb69ea770). By Monolith3D.

**Licence:** **CC BY-NC-SA 4.0** (the upstream repository's `LICENSE`, copied here unchanged). Redistribution is allowed with attribution (creator, licence link, and whether it was changed), **non-commercial only**, and adaptations must use the same licence. This repo is non-commercial.

Only the cable management clips are printed. The kit's `LDO_9mm_VT_NP_spacer` is only needed in No Protrusion mode, which is still a decision in `bom/printed-parts.md`, so it isn't copied.

| File here | Upstream path at the pinned commit | Qty | Our changes |
|---|---|---|---|
| `Cable_management_clip_S.stl` | [`STLs/Cable_management/Cable_management_clip_S.stl`](https://github.com/Monolith3D/LDO_Monolith_Gantry_Kits/blob/95cb5fc3957369aeb1e631f4656880bdb69ea770/STLs/Cable_management/Cable_management_clip_S.stl) | as-needed | none |
| `Cable_management_clip_M.stl` | [`STLs/Cable_management/Cable_management_clip_M.stl`](https://github.com/Monolith3D/LDO_Monolith_Gantry_Kits/blob/95cb5fc3957369aeb1e631f4656880bdb69ea770/STLs/Cable_management/Cable_management_clip_M.stl) | as-needed | none |
| `Cable_management_clip_L.stl` | [`STLs/Cable_management/Cable_management_clip_L.stl`](https://github.com/Monolith3D/LDO_Monolith_Gantry_Kits/blob/95cb5fc3957369aeb1e631f4656880bdb69ea770/STLs/Cable_management/Cable_management_clip_L.stl) | as-needed | none |

Each file's sha256 is in `../manifest.csv`; `platform/parts/check-printed.py --upstream` re-downloads every file at its commit and compares.
