dvystrcil/vt350/parts/printed/madmax/README.md

# MadMax toolchanger, plus andrewmcgr's XOL-A4T-Cartographer mod (in `andrewmcgr/`)

Copied **unchanged** from [zruncho3d/madmax](https://github.com/zruncho3d/madmax) at commit [`6bf670d`](https://github.com/zruncho3d/madmax/tree/6bf670de9adcc5924e2fb552978161d7a9c7b1c8). By zruncho3d (MadMax) and andrewmcgr (the mod).

**Licence:** **GPL-3.0** (the upstream repository's `LICENSE`, copied here unchanged). Redistribution is allowed, including of modified versions, under the same licence. It requires: the licence text alongside, the copyright and licence notices kept, and the corresponding source available. For a printed part the source is the upstream CAD, which stays at the pinned commit linked below.

andrewmcgr's mod lives in the same repository under `User Mods/andrewmcgr/XOL-A4T-Cartographer/` and has no licence file of its own, so the repository's GPL-3.0 applies (the same reading as `cad/derived/madmax-andrewmcgr-*`). Its CAD (`MadMax 4 XOL v11.step`, `.f3z`) is in the mod's `CAD/` folder at the same commit.

| File here | Upstream path at the pinned commit | Qty | Our changes |
|---|---|---|---|
| `SpeedClip_4mm_Gap_9mm.stl` | [`STL/SpeedClip_4mm_Gap_9mm.stl`](https://github.com/zruncho3d/madmax/blob/6bf670de9adcc5924e2fb552978161d7a9c7b1c8/STL/SpeedClip_4mm_Gap_9mm.stl) | 2 | none |
| `andrewmcgr/Plate Assembly.stl` | [`User Mods/andrewmcgr/XOL-A4T-Cartographer/STL/Plate Assembly.stl`](https://github.com/zruncho3d/madmax/blob/6bf670de9adcc5924e2fb552978161d7a9c7b1c8/User%20Mods/andrewmcgr/XOL-A4T-Cartographer/STL/Plate%20Assembly.stl) | 2 | none |
| `andrewmcgr/Plate Back.stl` | [`User Mods/andrewmcgr/XOL-A4T-Cartographer/STL/Plate Back.stl`](https://github.com/zruncho3d/madmax/blob/6bf670de9adcc5924e2fb552978161d7a9c7b1c8/User%20Mods/andrewmcgr/XOL-A4T-Cartographer/STL/Plate%20Back.stl) | 2 | none |
| `andrewmcgr/Dock Asembly.stl` | [`User Mods/andrewmcgr/XOL-A4T-Cartographer/STL/Dock Asembly.stl`](https://github.com/zruncho3d/madmax/blob/6bf670de9adcc5924e2fb552978161d7a9c7b1c8/User%20Mods/andrewmcgr/XOL-A4T-Cartographer/STL/Dock%20Asembly.stl) | 2 | none |

Each file's sha256 is in `../manifest.csv`; `platform/parts/check-printed.py --upstream` re-downloads every file at its commit and compares.
