dvystrcil/vt350/parts/printed/vt350/btt5160-base-4-middle-screws/README.md

# BTT TMC5160T Plus base (4 middle screws)

**The user's own design**, under this repo's GPL-3.0-or-later licence (see the root `LICENSE`). Made in Fusion 360 (STEP exported
2026-05-16), before the FreeCAD model pipeline, so it doesn't come from any `vt350-lite-N` model.

| File | What |
|---|---|
| `btt5160-base-4-middle-screws.stl` | the part to print (127 × 76.5 × 7 mm) |
| `btt5160-base-4-middle-screws.step` | its source |

For the [BTT TMC5160T Plus](https://global.bttwiki.com/TMC5160TPlus.html) drivers (2 owned, `notes/parts-owned.md`).
Stage 7, electronics (#13). Qty in the manifest is 1; check how many drivers one base holds before printing.
