dvystrcil/vt350/(commit log)

2026-11-04 docs: document the CAD pipeline, build status and cut list (#16)
    Saves everything from the 2026-11-04 CAD session so the build can be
    shelved and resumed:
    - notes/status.md: decisions, open questions, build stage order, where
    every file lives (the .FCStd models stay outside git: 140-510 MB)
    - notes/cut-list.md: extrusion lengths measured from vt350-lite-4
    after the +100 mm frame change
    - cad/README.md: how each model working copy was produced, how it was
    verified, FreeCAD performance setup, and the gotchas hit on the way
    - cad/scripts/: the FreeCAD scripts behind each working copy; paths
    now come from VT350_WORK (default cad/data) instead of a temp dir
    - cad/data/: fastener records,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
2026-11-04 docs: back up the model files with restic (#17)
    The .FCStd models are too big for git, so they were only on the laptop.
    cad/backup-models.sh backs them up with restic; --verify restores the
    newest model and compares checksums. The backup target and password are
    per-machine config (~/.config/vt350/backup.env), not in this public repo.
    First backup 2026-11-04: 52 files, 4.09 GB; restored models were
    byte-identical; restic check found no errors.
2026-11-04 CAD lite-5: drilled verticals restored, INDX removed, corner screws follow holes, bowden tubes (#20)
    lite-3 rebuilt the six verticals as extrusions of their end face and lost
    every side hole. lite5.py splices the original drilled bars from lite-2 at
    Z=534 instead (section checked equal to the end face, so no hole crosses
    the cut); hole faces 52/60/60/52/32/32 match lite-2.
    Also: INDX parts removed (MadMax-style toolchanger now); at the rear 4040
    corners the 15 M5x16 BHCS with no drilled hole are removed, leaving the 2
    staggered M5x50 through-bolts per joint; solid 4.12 mm bowden tube per
    head from the Orbiter inlet to a top-rear exit for the EMU. Headless runs
    are dry runs; the GUI run veri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
2026-11-04 bom: first-pass printed parts list (Trident R1) (#23)
    * bom: first-pass printed parts list (Trident R1 + kits/mods)
    Refs #8 #22
    * bom: door is the Clicky-Clack fridge door (3 hinges, 2040 frame)
    ---------
2026-11-05 notes: A4Tv2 + O2S head size (AC9) and tool count (#25)
    * notes: A4Tv2 head width (73.4 mm) and updated tool count
    Refs #19
    * notes: A4Tv2 + O2S head measured (AC9); correct the WW-BMG mix-up
    The first A4Tv2 measurement filtered 'wwbmg' but the STEP labels it
    'WW-BMG', so the WW-BMG extruder stood in for the Orbiter. Re-measured
    with an explicit part list plus the official Orbiter 2.5/OSS/O2S
    assembly seated on the crossbow adapter: width 73.4 (unchanged),
    worst-slice depth 68.6 with the plate -> go deep by 80 mm.
    ---------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
2026-11-05 CAD lite-6: +80 mm Y at the front, Monolith milled 2WD, Carbonara beam, MGN9 rails (#26)
    From the user's lite-5-dan. Everything in front of Y=10 moves -80; Y bars
    spliced; old front verticals stay as Z posts (they carry the front Z
    rails); new front verticals and bottom crossbar; placeholder dock
    crossbar. LDO Monolith milled 2WD VT 9mm (rear NP: FT hits the rear
    gantry 2020) aligned on the printed parts' pulley axes; MGN9 x 470 Y
    rails; Carbonara 430 CF X beam; belts spliced; Z cable anchors removed;
    bowden tubes regenerated. 0 problems; 5 new collisions documented.
2026-11-05 CAD lite-7..11: belts, Y rails, Y reach, taller Z (~348 mm), review fixes (#27)
    * CAD lite-7: re-draw both XY belts on the Monolith milled 2WD path
    lite-6 still had lite-5's belts, drawn for the printed AWD joints
    (2.2-2.8 mm off the milled ones) and short of the front idlers. Each belt
    is now its GT2 pitch line through the milled pulleys/idlers, ending at
    the carriage clip's outer edge: 1941.7 mm each, valid single solids,
    touching nothing but their clips. The printed Y endstop is removed: it
    sat in the lower belt's rear run and shared a slot with the milled rear
    mount.
    * CAD lite-8/9: Y rails 450, then owned 400 steel + 74 mm front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
    [materials-lite12.tsv]
2026-11-05 notes: parts owned as of 2026-11-04 (#28)
    * notes: parts owned as of 2026-11-04 (rails, Orbiter 2.5, 60 V PSU, Nitehawk Hexa, Wagos, SSR clamp)
    * notes: record the owned 60 V PSU (BOSYTRO 600 W, adjustable)
    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
2026-11-05 notes: TMC5160T Plus input limits, 60 V PSU, time relay for power sequencing (#29)
    * notes: TMC5160T Plus input limits for the 60 V PSU (set 48 V; HVIN 8-56 V)
    From the BTT wiki: HVIN 8-56 V (spec table), driver power before logic
    power, mainboard-to-driver voltage never above 24 V, active cooling
    above 3 A.
    * notes: owned TBT7-C1 time relay for driver-before-mainboard power-up
    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
2026-11-05 CAD lite-13: backbone steel, kinematic bed-mount supports aluminium (#30)
    Confirmed by the user. Also sets the back kinematic ball to steel, which
    lite-12's rule missed. data/materials.tsv lists every solid's current
    material.
    [materials.tsv]
2026-11-05 CAD lite-14: docks 5 mm back, dock arms lengthened, so the carriage reaches pickup (#31)
    The dock assembly's carriage copy (pickup pose) was 2.81 mm beyond the
    carriage's front limit; the earlier 6.8 mm used the wrong reference.
    Docks + docked heads move +5 mm in Y (2.19 mm short of the hard stop),
    the printed dock arms get 5 mm through their straight section, bowden
    tubes rebuilt. Also notes WireViz for the stage-13 wiring docs.
2026-11-05 Add the 5 mm longer MadMax dock arm (GPL-3.0, derived from andrewmcgr's) (#32)
    Printable STL for lite-14's longer dock arms. The original is from
    zruncho3d/madmax (GPL-3.0), User Mods/andrewmcgr/XOL-A4T-Cartographer,
    commit 6bf670d. It lives in cad/derived/ with its own LICENSE and a README
    recording source, change and date; the top-level README notes the
    exception to MIT.
    [Dock Arm +5mm.stl]
2026-11-05 notes: A4Tv2 remix OK from its creator; licence split (CC BY-NC-SA vs GPL); mount holes match the MadMax XOL plate (#33)
2026-11-05 CAD lite-15: A4Tv2 + CNC Crossbow on both heads; MadMax plate fits unmodified (#34)
    Placed from DW-Tas's A4Tv2 assembly by all three XOL screw pairs on
    andrewmcgr's MadMax plate. Removes the v1 cowling/duct/LED/hotend mock-up
    and the older Crossbow; Orbiters seated on the new adapter; bowden tubes
    rebuilt. Known conflict left visible: the left head's Crossbow lever hits
    the left dock brackets. Corrects the earlier hole-match note (#33).
2026-11-05 CAD lite-16: insulation, Obico camera, LED strips + render pipeline (#35)
    * CAD lite-15: A4Tv2 + CNC Crossbow on both heads; MadMax plate fits unmodified
    * CAD lite-16: insulation, Obico camera, LED strips; Cycles render pipeline; kinematic-bed findings
    Felt (3 owned pads) sealed in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
2026-11-05 Add lite-16 Cycles renders (Obico camera view, outside 3/4) to cad/README (#36)
2026-11-05 CAD lite-17: tanaes Trident kinematic bed mounts, 10 mm build plate (#41)
    tanaes's laser-cut Trident set (the user's West3D kit) replaces the printed
    Z_Bed holders and the V2.4 kinematic parts. The parts are built from his DXFs
    at the BOM thicknesses. A, B and G are anchored on the GE5C bores, with I on
    top. C/E and D/F are slid along the front slot until the pin groove runs
    through the bed's own front mount hole. That lands them 54.7 mm inboard of A's
    bore, the spacing his DXFs are drawn at. GE5Cs and the Z carriages (plus the Z
    cable chain) move to the new bearing height. The plate is the user's measured
    10 mm.
    Dry run and GUI run: 0 problems, 0 overlaps, 0 broken contacts.
    Co-authored-b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
2026-11-05 CAD lite-18: the measured LDO build plate, heater pad and hold-downs under the kinematic mounts (#42)
    lite18_plate.py replaces the model's generic plate with the user's LDO plate, measured 2026-11-05:
    355 square x 10, every hole 3.4 + 6.5 x 4.9 counterbore. It adds the 1.5 mm heater pad with its cut-outs
    (from a photo of the underside, +-1 mm), the 4 pad hold-downs (3.8 below the plate) and the 1.4 mm magnet sheet.
    The front balls stay under the K341 holes. The rear ball slides 1.5 mm along G's groove to the real rear hole.
    Findings: the springs sit inside the pad cut-outs to within 0.5 mm, which is below the photo's resolution.
    The front hold-downs clear C/D by 3.5 mm. The bed bolts should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
2026-11-05 notes: bed bolts are M3x10 (not 14); fastener stacks through the C/D/H sandwiches (#43)
    tanaes's README has the sphere nut take only the 2-3 mm of thread past the thin hex nut, so the
    bolt is 7.28 + 2-3 = M3x10. lite-18 measured: the C/D/H clamp screws (M3x8) get 1.9 mm of thread;
    M3x10 is safe at H (nothing below G there) but not at C/D (the tapped holes sit on the extrusion's edge).
2026-11-05 CAD lite-19: move the electronics box to its own document (vt350-ebox.FCStd) (#44)
    The Electronics and Electronics Cabinet assemblies (324 objects, 102 solids) are copied with their
    hierarchy, global placement and colours into vt350-ebox.FCStd, then removed from the printer. A
    transparent envelope box stays in their place. Every copied solid was checked against its original.
2026-11-05 docs(cad): render on node-03: export, submit, result arrives (#46)
    The homelab GPU batch lane (dvystrcil/homelab#1935 AC6). render.py is
    unmodified; node-03 matched the laptop's lite-16 renders to sampling noise.
2026-11-05 CAD lite-20/21: re-measured rear hole row; BTT Pad 7 screen removed (#47)
    * CAD lite-20: re-measured rear hole row and rear heater-pad strip
    Two ruler photos of the plate's underside (cm ticks located by pixel
    column profiles) put the rear hole row 6.55 mm from the rear edge, not
    5.5: the first photo estimate stopped at the ~1 mm edge chamfer, the
    same bias the front row had. The row is now at 348.5 (symmetric with
    the front row's 6.5), the rear pad strip is 12.3 deep (was 11.3), and
    the fuse / lock-washer screws are at 122.1 / 232.8.
    The rear ball, nut and spring slide 1.0 mm forward along G's groove.
    The rear spring is now clear of the pad. Every other solid keeps its
    exact bounding box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
2026-11-05 CAD lite-22: heater pad cut-outs and front-ball holes measured with calipers (#48)
    The user measured the plate (heater side up, front nearest, from the
    outer edge): K341 front-ball holes 7 / 43 (confirmed), side strips
    12.5 wide from 28.5 to 58.5 (were 11, 28-59), front notches 87-117 and
    12.5 deep (were 85-120, 10.3), fuse / lock-washer screws 55 from the
    centre (110 apart) -> 122.5 / 232.5. A follow-up ruler photo confirms
    the rear R150 pair at 150 C-C about the centre hole (unchanged).
    Every photo estimate of a pad edge was 1.5-2 mm short: the edge chamfer.
    The front springs' corners now overlap the pad by 1.7 / 6.8 mm2 (slivers
    at the strips' front ends, springs drawn before preload): c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
2026-11-06 CAD: clashlib, parallel read-only clash checks on N freecadcmd workers (#45) (#49)
    clashlib.run(model, groups, poses, ...) starts N = cores - 2 headless
    freecadcmd workers on the saved model. Pairs are moving group x fixed
    solids (or group x group) at each pose, translations only, split
    round-robin by the fixed solid. Each worker prefilters with an enlarged
    optimalBoundingBox, then runs Shape.common(); the parent merges the JSON.
    Workers never save.
    clash_lite18_repro.py re-runs lite-18's clash rule on the saved lite-18:
    the same 3 pairs and volumes (0.3565 / 2.0368 / 0.6441 vs the logged
    0.36 / 2.04 / 0.64 mm3), with 1 worker and with 10. Clash stage 65.7 s
    serial vs 15.1 s parallel; wall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
2026-11-06 CAD: toolhead collision sweep on lite-22 (#19 AC5) (#50)
    sweep_toolhead.py (headless, read-only) puts each A4Tv2 head on the
    MadMax carriage by transform, using the dock's carriage copy at pickup.
    It moves bed (Z), gantry (Y) and carriage + head (X+Y) through the 4
    corners + centre of the 350 square x bed top/bottom and the head's own
    dock pickup. It also scans X inward from each side and checks the head
    against its own plate brackets. Runs on clashlib (10 workers, ~9 min).
    Findings: each head's plate bracket (either variant) hits the XY joint on
    its dock side, so the usable nozzle X is -406..-72 (left head) and
    -418..-84 (right head). The rear Y reach is 375.47, 5 mm short of the
    square. T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
2026-11-06 CAD render: export a toolhead-sweep pose with the clash volumes (#19) (#51)
    export_pose.py (headless, never saves) poses the model with
    sweep_toolhead.plan(). Parts are coloured by role, the overlap volumes are
    written as their own bucket, and scene.json gets close-up views.
    render.py renders scene.json "views" when present, with per-view hide and
    alpha, and makes the "clash" bucket glow. Scenes without views render the
    obico/outside views as before.
2026-11-06 CAD lite-23: MadMax dock screws on bosses on the A4Tv2 4010 ducts (#53) (#55)
    The Dock and Alternate Brackets are gone. Each head's 4010 duct gets three
    bosses with Voron M3 insert pockets on the MadMax dock-screw pattern; each ends
    0.2 mm inside the duct wall's solid section (no air-channel intrusion) and keeps
    >= 0.4 mm off the fan screws and the tilted body-screw counterbores.
    Heads park 12.5 mm further back; keyslot plates move (0, -14.06, -5.78); both
    arms of each dock are 14.06 mm shorter through their constant section. Pickup
    at the keyslots' large opening has +8.69 mm before the hard stop (lite-22:
    -3.81). Pocket axes vs moved keyslots 0.0004 mm; no new collisions; bowden
    tubes rebu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
    [A4Tv2 Duct-4010-left MadMax dock.stl, A4Tv2 Duct-4010-right MadMax dock.stl, Dock Arm -9.06mm.stl]
2026-11-06 CAD lite-24: Beacon RevH under the MadMax carriage at 2.6 mm (#54) (#56)
    * CAD lite-23: MadMax dock screws on bosses on the A4Tv2 4010 ducts (#53)
    -3.81). Pocket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
    [MadMaxCarriage Beacon RevH pocket.stl]
2026-11-06 CAD: re-sweep toolheads on lite-24 with belts, Beacon, large-opening pickup (#53) (#57)
    at the keyslots' large opening has +8.69 mm before the hard stop (lite-22: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
2026-11-06 CAD lite-25: 9 mm belt pockets + SpeedClips on the MadMax carriage (#58) (#62)
    The belts are 9 mm, but andrewmcgr's MadMax carriage (Beacon pocket) is the
    stock 6 mm-belt carriage with 6 mm SpeedClips. lite-25 swaps its two clip
    pockets for upstream's Carriage_MGN12H_9mm ones on the gantry carriage and
    both dock copies, keeping the probe pocket and lite-24's Beacon cut. The six
    clips become upstream SpeedClip_4mm_Gap_9mm.
    - lite25_carriage_9mm.py: GUI pass, headless = dry run; 0 problems
    - printable carriage in cad/derived (GPL-3.0); BOM points at the 9 mm parts
    - reglib.py: registration moved out of derive_stls.py (re-run is
    byte-identical)
    - sweep on lite-25: reach and attach-slide resu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
    [MadMaxCarriage Beacon RevH pocket 9mm belts.stl]
2026-11-06 Printed parts: every part this build prints, in parts/printed/ (#63) (#64)
    Copies every "print" row of bom/printed-parts.md into parts/printed/, unchanged and
    pinned to an upstream commit: Voron Trident (VTr1), MadMax + andrewmcgr's
    XOL-A4T-Cartographer mod (6bf670d), A4Tv2 (888755a), the LDO Monolith kit clips
    (95cb5fc) and the Clicky-Clack door (62268ed). Each source folder has the upstream
    LICENSE and a README with the repo, commit, upstream paths and "our changes: none".
    The licence of every source, including the ones not printed (A4T v1, Toolheads for
    Monolith, EMU), is in parts/printed/README.md.
    Our remixes go in parts/printed/vt350/ as copies of cad/derived/ (current versions
    only):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
    [10mm_extrusion_drill_guide.stl, 140mm_extrusion_drill_guide.stl, A4Tv2 Duct-4010-left MadMax dock.stl, A4Tv2 Duct-4010-right MadMax dock.stl, Cable_management_clip_L.stl, Cable_management_clip_M.stl, Cable_management_clip_S.stl, Dock Arm -9.06mm.stl]
2026-11-06 CAD lite-26: MadMax carriage on the MGN12H block, not the X rail (#61) (#66)
    The gantry carriage's ~3 mm block recess sat on the rail's front face
    (Y 265.6 vs 265.5) in every model since the original assembly; the
    block top is 260.825. lite26_carriage_on_block.py moves the carriage,
    its SpeedClips and the Beacon dY -4.775 (measured by ray probes).
    Carriage/clips x rail and carriage x block go to 0; Beacon offset
    unchanged; pickup margin +8.69 -> +13.46; rear Y reach 375.47 ->
    370.69. Re-sweep on lite-26: X reach -416..-74 (clip ends vs XY-joint
    idler bearings); attach-slide belt x parked plate contact gone
    (>= 0.79 mm clear, belt_plate_gap.py). No shape changed: cad/derived
    and parts/printed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
2026-11-06 Print-area drawing: plate, 350 square and nozzle reach (#67) (#68)
    cad/scripts/print_area.py draws cad/data/print-area.svg from the
    sweep_toolhead.py log (reach, tightest head per side) and the plate
    constants in sweep_toolhead.py. lite-26: 342.0 x 340.19 mm printable
    (left/right -4, rear -9.81, front 0). test_print_area.py fails when the
    committed drawing no longer matches the log; new print-area workflow
    runs it.
    Refs #67
2026-11-07 CAD refresh chain: one command after a model change (#69) (#71)
    cad/scripts/refresh.py runs derive_stls -> sync_printed -> check_printed ->
    sweep -> print_area -> test_print_area. It stops at the first step that
    fails its exit code OR its completion marker, and never saves a model or
    commits. sync_printed re-copies changed in-repo parts and rewrites only
    their sha256 cell in manifest.csv (text edit, the rest stays byte-identical).
    sweep_toolhead.py takes VT350_MODEL (default unchanged: lite-26).
    Tested on lite-26: 0 STLs changed, the sweep log matches the committed one
    apart from timings, print area 342.0 x 340.19. That first run failed closed
    on a wrong test_print_area marker; test_refresh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
2026-11-07 notes/scripts.md: the scripts at hand, when and how to run them (#72)
    What to type after a model change (refresh.py), before/after one
    (backup-models.sh), for printed parts, sweeps, renders via the GPU batch
    lane, and which handoff lanes are live vs planned (#70, homelab#1961,
    homelab#1962). Linked from README.
2026-11-07 Renders in colour on this laptop: render_full.sh + a render-time colour map (#38) (#73)
    cad/render/render_full.sh [N] [samples] runs the FreeCAD GUI export of lite-N
    plus vt350-ebox.FCStd, then Blender Cycles on the RTX 2070 (OPTIX), into
    ~/Documents/VT350/renders/<model>-<UTC>/. It fails if the export or the
    images are missing.
    Colours live in cad/render/colours.json, not in the model (user,
    2026-11-06): seafoam green powder-coated frame extrusions, PET-GF white
    printed parts, PET-GF orange [a]_ accents. Ordered regex rules on label,
    group path and ShapeMaterial; unmatched parts keep the model colour, and
    export.log lists them. colours.py is the shared matcher (tested).
    export_meshes.py bu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
2026-11-07 Render colours: backbone, belts, Monolith parts, bearings (#38) (#76)
    * Render colours: backbone, belts, Monolith parts, bearings; reuse reads the current map
    User, 2026-11-06: the bed backbone and the Monolith milled parts are matte
    black, the belts brown almost black, the bearings chrome-ish. New roles
    and rules, each tested on real lite-26 labels. render.py now takes role
    colours from the current colours.json, so VT350_REUSE_EXPORT picks up a
    colour-only edit (a new rule still needs a full export; documented).
    Re-rendered lite-26: 26 frame, 40 printed, 6 accent, 1 backbone, 2 belt,
    18 Monolith, 68 bearing solids.
    * notes/scripts.m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
2026-11-07 Slicer check: headless PrusaSlicer report, keep-out boxes and G-code preview (#70) (#77)
    parts/slice-check.py <stl…> slices each print-oriented STL with the pinned
    parts/slice/petg-0.4-0.2.ini (PETG 0.4/0.2, auto supports < 45 deg) and an
    empty --datadir, then reports support yes/no + volume (from ;TYPE:Support
    extrusion), time, filament and slicer warnings. It fails (exit 1) on support
    inside a keep-out box (keepout.json, STL coordinates). Previews are a G-code
    plot (top/front/side, support red) via rsvg-convert, because the PrusaSlicer
    2.9 CLI has no preview export. Output: ~/Documents/VT350/slice/<UTC>/.
    Verified on 6 real parts (all print-oriented upstream STLs; auto supports
    still ad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
    [petg-0.4-0.2.ini]
2026-11-07 fix(render): export_meshes.py imports colours from its own directory (#79)
    It used to insert /home/dan/Code/vt350/cad/render into sys.path, so it
    only ran from this laptop's clone. The vt350-render chain (homelab#1961
    AC5) runs it in a gpu-batch-freecad pod from a copy on the NFS share.
    render.py already does this.
2026-11-08 render.py writes the README JPEG next to each PNG (homelab#1961) (#81)
    cad/README.md shows renders/<model>-<view>.jpg, 1920x1080 at quality 85,
    while render.py wrote only PNGs (~2.4 MB each), so every re-render needed a
    hand conversion. render.py now saves the same render result as a quality-85
    JPEG beside the PNG master (Blender's own writer, same view transform: RMSE
    0.2-0.3% vs the PNG). The batch lane's vt350-render chain then produces the
    files that drop into cad/renders/ (homelab#1961 AC8).
    test_render.py renders a one-box fixture at 1 sample and checks both files
    per view: PNG 1920x1080, JPEG 1920x1080 whose luminance table is IJG
    quality 85 (the parser is checked against the committ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
2026-11-08 lite-27: levelling feet + base board, StealthMax recessed in the backbone (#83, #74) (#85)
    User decisions 2026-11-08: #83 options 2+5 (4040 T-slot M8 levelling feet on a
    rigid base board) and #74 option A (StealthMax filter fully recessed below the
    backbone's top).
    - cad/scripts/lite27_feet_filter.py (GUI writes, headless = dry run): lite-26 ->
    lite-27 with 4 placeholder levelling feet and an 18 mm board (frame bottom
    50 mm above it), plus vt350-filter.FCStd: the StealthMax 300 core (22 parts
    from upstream CAD/StealthMax_300.step @ a3451c5, GPL-3.0) in the 350 x 330
    cutout at Z -80.0..-4.4. The printer keeps a transparent "Filter envelope",
    like the ebox. Refuses to save unless: f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
2026-11-08 render.py: frame the low views on the base (#74, #83) (#86)
    The first lite-27 lane render put the printer in the top half with the bottom
    40% empty. Cameras now 30 mm above the board and ~850 mm from the base, 35 mm
    lens; low_side +1 EV (unlit side). Tuned on 16-sample local previews of the
    lane's export (vt350-lite-27-20261108t195459-90b1).
2026-11-08 lite-28: StealthMax hangs by side lips on the backbone; drag chains orange (#74) (#87)
    User, 2026-11-08: the filter hangs by a lip 10 mm over the backbone's top edge
    and is lifted out from above; recirculate only; orange accents on the filter;
    all drag chains orange.
    - cad/scripts/lite28_filter_lips.py (GUI writes, headless = dry run):
    vt350-filter -> vt350-filter-2 with two concept hangers (lip on the backbone
    top, drop down the cutout gap, tab into the main chamber wall under the lid
    frame, split around the lid latch); lite-27 -> lite-28 with the grown filter
    envelope. Lips on the left/right edges only: the bed frame's 2020 T rests on
    the front and rear edges at the bottom of Z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
2026-11-08 colours: dock crossbar (2040 above the toolheads) in the frame seafoam (#88)
    User, 2026-11-08. The frame rule matched only labels starting with
    2020/2040/4040; lite-6's placeholder crossbar is labelled 'Dock crossbar
    (placeholder, 2040)'. Test first.
2026-11-09 lite-29: StealthMax sits in a two-half cradle on the backbone (#74) (#94)
    User, 2026-11-08: two halves, left and right, the filter sits in the cradle and
    lifts out. Replaces lite-28's four hanger pieces (each side was split around
    the lid latch because its tab went into the wall).
    - cad/scripts/lite29_filter_cradle.py (GUI writes, headless = dry run):
    vt350-filter-2 -> vt350-filter-3, lite-28 -> lite-29. Each half is one
    piece: lip on the backbone top, wall down the cutout edge, 15 mm ledge under
    the filter's bottom tray (M_1a.0_Body_BPM, underside Z -79.9), 3x5 ridge.
    The first dry run caught the ledge cutting into that tray (it was under the
    chamber floor, 15 mm higher).
    Check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
2026-11-09 CAD: litelib, a shared lite-N pass module with named clearance checks (#93) (#95)
    lite-28 and lite-29 each carried ~150 lines of the same skeleton. litelib.py
    holds it: Pass (log, check, vol, open -> Model, run, finish, dump,
    add_solids, resize_envelope) and six named checks, each one ok/FAIL log
    line: on_face, over_material, clear_of_bed_travel, no_overlap,
    min_distance, lift_out_clear. no_overlap's booleans go through
    Pass.volumes(pairs), the hook for a parallel runner (#45).
    lite28_filter_lips.py and lite29_filter_cradle.py are rewritten on it.
    Their headless dry-run logs and JSON match the pre-refactor headless runs
    line for line (timestamps stripped). No model was saved.
    test_litelib.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
2026-11-09 CAD: lite-30 filter cradle, TPU seals, tub + side intakes (#74) (#97)
    * CAD: lite-30 filter ring + TPU cutout seal, fits_print_area check (#74)
    lite30_filter_ring.py, the first pass on litelib (#93): one ring replaces
    lite-29's two cradle halves. 4 mm collar 1.5 mm inside the cutout,
    concentric with its measured R10 corners, top Z -3; lite-29's side lips,
    walls, ledges and ridges; a 1 mm channel for a 3 x 3 TPU cord squeezed
    0.5 mm against the cutout edge, as left and right U halves (lap at X -245).
    Headless dry run: 0 problems. Front/rear ledges and the ducts are not in
    yet (airflow trace on #74).
    litelib: fits_print_area(shape, what, area=None, margin) and
    print_area(), read from print_a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
2026-11-09 render: exploded view uses the colours.json roles (#74) (#98)
    The whole filter was one flat grey, so its orange latches, hinge and logo
    cap washed out against the white bodies. The filter is now split into
    one bucket per colours.json role (accent, printed), plus the acrylic
    panel (see-through) and the unnamed parts (fan, HEPA, hub, sponge: dark).
    The backbone and cradle take their roles too (matte black, accent).
2026-11-09 render: Voron logos orange with a white inset (#74) (#99)
    * render: Voron logos orange with a white inset, logo close-ups (#74)
    The front hinge hexagon and the top logo cap are each one solid, so the
    inset is picked by face: the three slash floors (planar, facing out, at
    the measured depth: hinge Y -85.1, cap Z -11.5) plus the walls and
    chamfers touching them. They go in their own bucket with the printed
    (white) role; the rest of each part stays accent orange. The export
    fails if it doesn't find exactly 3 slash floors on each part. Two
    close-up views (logo_front, logo_top) added.
    * render: Voron logo inset in the full printer too; on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
2026-11-09 CAD: litelib's named checks on parallel workers, bit-identical to serial (#45) (#100)
    * CAD: run litelib's named checks on parallel workers, bit-identical to serial (#45)
    Every named check's heavy work now goes through one hook, Pass.map(fn, tasks): no_overlap's booleans (via
    Pass.volumes, kept), min_distance's distToShape, lift_out_clear's column booleans and exact line grid (split into
    2 x workers strips), and Model.boxes (clear_of_bed_travel's optimal boxes). New litepool.py: persistent headless
    freecadcmd workers over socketpairs, dynamic dispatch, results in order, a dead worker fails the map.
    Bit-identical by construction: workers rebuild document shapes from the same saved file with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
2026-11-09 CAD: per-part bounding-box index beside each model, so layout questions are a jq query (#90) (#103)
    cad/scripts/part_index.py writes <model>.parts.json next to each .FCStd (format
    vt350-part-index/1). It has one entry per litelib leaf solid: label, group path, material,
    consumed, and the global optimalBoundingBox(True, False) from Model.boxes. The index records
    the mode that made the boxes (gui or headless; a GUI run never uses the headless workers) and
    the model's size + sha256, so `part_index.py --check` (plain python3) can tell whether the
    index is fresh. The model is never saved.
    export_meshes.py (render_full.sh's export) refreshes the index of every model it exports.
    A failure there is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
2026-11-09 refresh.py: index the model and its companions first (part_index step, #90 AC3) (#104)
    refresh.py N now starts with a part_index step. It runs headless freecadcmd part_index.py on
    vt350-lite-N.FCStd and on every companion the same pass saved: another .FCStd in the folder
    saved within COMPANION_S (10 min) of it, never another lite-N. The real data agrees:
    lite-29 -> filter-3, lite-28 -> filter-2, lite-19 -> ebox. A fresh index is skipped. The
    summary prints each model's index status.
    The runner also stops trusting a stale log. A completion marker read from a separate log
    (derive_stls, sweep, part_index) now counts only if this run rewrote that log, so a step
    that crashes before writing its l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
2026-11-09 part_index --adopt: bring a batch-lane index back beside the laptop model (#90 AC3) (#105)
    * part_index --adopt: bring a batch-lane index back beside the laptop model (#90 AC3)
    The vt350-refresh / vt350-render chains (homelab gpu-batch-submit.py) leave each staged
    model's index in <job>/out/index/. `part_index.py --adopt [--models DIR] INDEX...` copies
    one beside DIR/<its model> only when that model has the exact size + sha256 the index was
    made from, never over a fresh local index, and never outside DIR (the model name must be a
    bare .FCStd name: the index comes from a pod). Plain python3; never opens a .FCStd.
    Tests: test_part_index.py Ran 48 / OK; mutation 21/21 killed on the new code.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
2026-11-09 tests: remove every temp dir they make, and a CI check that they do (#107)
    test_litepool, test_prove_parallel, test_refresh, test_render, test_litelib
    and test_part_index_fc each left dirs in /tmp on every run. Together with
    other suites' leaks (and mutation runs, which multiply them) they used all
    1,048,576 inodes of the laptop's /tmp tmpfs and broke every tool on it.
    cad/scripts/check_test_tmp.sh runs each python3 test file with its own
    empty TMPDIR and fails if anything is left. It is red on main (litepool 10,
    prove_parallel 6, refresh 2 entries) and green here. The FreeCAD/Blender
    tests are skipped there; they were checked by hand under freecadcmd and leave
    nothing behind. New workflow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
2026-11-09 clashlib, litepool, sweep_toolhead: remove their temp dirs on every path (#108)
    Real runs, not just tests, left clashlib-* (59), litepool-* (17) and sweep-*
    (12) dirs in /tmp.
    - clashlib.run: the job dir is removed when run() returns or raises, unless
    the caller passed keep_dir; workers still running (a timeout) are killed
    first. Failures already carry each worker's stderr tail.
    - litepool.Pool: a weakref.finalize ends any worker still running and removes
    the dir. close() runs it; so does dropping the pool or exiting without close().
    - sweep_toolhead: the plan stage is plan_stage(), in a TemporaryDirectory.
    New test_clashlib.py and test_sweep_toolhead.py (fake workers, in CI via
    refr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
2026-11-10 z_sweep: the bed's Z travel, both ends, by boolean contact (#82) (#112)
    * z_sweep: the bed's Z travel, both ends, by boolean contact (#82)
    cad/scripts/z_sweep.py is a headless, read-only litelib pass. The bed (sweep_toolhead's
    classification) moves down and up against every other solid, plus the solids of the
    documents the model's envelopes name (the envelope boxes themselves are left out).
    - Lower end: the first common() contact, or a Z block's bottom end reaching its rail's,
    whichever comes first. Rail ends are measured with Part.makeLine ray probes.
    - Upper end: each head carried over the print centre. The first touch must be the magnet
    sheet on that head's nozzle.
    - Logs z_lower_lim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
2026-11-10 z_sweep: the bed's full travel in Klipper terms (#82 AC6) (#113)
    * z_sweep: the bed's full travel in Klipper terms (#82 AC6)
    Klipper's Z0 is the nozzle touching the print surface, and on a Trident Z goes negative above it.
    z_upper_limit_mm is that Z0, not the top of the bed's travel. So far the upper searches always had
    something over the bed: a carried head over the centre, or the carriage at the model pose.
    New case: the toolhead parked at each dock (sweep_toolhead's "dock pickup, top": gantry and carriage
    translated, both heads docked, belts left out), searched by boolean contact up to the rail-stop cap.
    The mechanical top is the higher parking's first touch (parked_top), or a Z block's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
2026-11-10 Bed floor 5 mm above the backbone (printer.cfg position_max 330.33) + lite-29 refresh baseline (#117)
    * sweep_toolhead: bed-bottom poses at the measured lower stop, not a box estimate
    plan() set the bed-bottom poses from a bounding-box landing search. lite-27 added the filter
    ENVELOPE (a placeholder box), and on lite-29 the search landed the bed-frame 2020 on that box at
    dZ -238.00. The real stop, from z_sweep's boolean contact (vt350#82), is -242.00
    (litelib.BED_LOWEST_DZ), and the filter's contents clear the spine by 2.5 mm.
    bed_bottom() now returns the measured stop. The box estimate is still logged as a cross-check.
    It refuses an estimate below the measured stop: a box can only land ea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
    [printer.cfg]
2026-11-10 Kalico batch mode: printer.cfg limits checked against the CAD (#116 AC1-AC3) (#118)
    * Kalico batch mode: printer.cfg limits checked against the CAD (#116 AC1-AC3)
    Part of #116, ACs 1-3 (AC6's CI too). AC4 onwards is not started.
    - cad/klipper/kalisim/: the core, with no FreeCAD dependency (GPL-3.0-or-later). It
    runs Kalico batch mode with one -d dictionary per MCU and reads back a move
    timeline written by a Kalico plugin (plugins/move_timeline.py).
    Dockerfile: the runtime is Kalico's published image, pinned by digest
    (klippy/.version g991e1823). A first stage builds the three dictionaries from
    source at KALICO_SHA 991e1823 (Octopus Pro H723; 2x O2S F072 with a 12 MHz
    crystal, n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
    [printer.cfg]
2026-11-10 CAD: lite-30, Orbitool O2S + Orbiter Smart Sensor on both heads (#6 AC2, AC3, AC6) (#123)
    * CAD: lite-30, Orbitool O2S + Orbiter Smart Sensor on both heads (#6 AC2, AC3)
    From the Orbiter designer's STEP (LorinczElectronics/Orbiter-Toolboards
    @ 52a5a33, CC0-1.0). register.py pairs the STEP's Orbiter with each head's
    mockup: 14 of 15 solids fit to 0.0003 mm, but the head's hub sat 2.000 mm
    low against its own motor/gear stack. The hub is seated on the Crossbow
    adapter, so the stack moves -2.0 onto it, then all 15 fit. O2S board,
    standoffs, USB stub and Smart Sensor added at the hub pose; both
    Nitehawk-36 placeholders and the old inlet coupler + brass ring removed;
    bowden tubes rebuilt from th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
2026-11-10 Notes: reference page, Orbitool O2S vs Nitehawk-36 (#6) (#126)
    A styled HTML comparison: chamber rating, Smart Sensor, CAD, and the cost of
    switching, from the O2S manual v1.5, LDO's Nitehawk-36 docs and the repos.
    notes/reference/README.md says how to view such pages rendered.
2026-11-10 Kalico: Z position_min -15, from the AC4 macro source (vt350#116) (#128)
    Z0 comes from the Beacon nozzle tap and shifts by fractions of a mm per
    nozzle. position_min is how far below Z0 Kalico accepts a command, so 0
    would refuse negative per-tool Z offsets and calibration moves. -15 matches
    MadMax r2pdx_config-v2-Kalico-Beacon @277a63c, the macro source chosen for
    AC4 (owner, 2026-11-10).
    - limits.py: Z position_min may sit at or below the CAD floor (0); every
    other limit must still equal the CAD's.
    - envelope: corners stay on the plate (Z 0); one extra in-range move to
    the negative min; "past z_min" is now one step below -15.
    - printer.cfg cites the MadMax config for Z min; a test pin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
    [printer.cfg]
2026-11-10 Notes: Orbiter hub explainer page; owned motor, Nitehawk-36, PSU (#6) (#129)
    - notes/reference/orbiter-hub.html + orbiter-hub/*.jpg: the hub housing
    explainer (lite-30 renders, in place / pulled apart / alone; LDO model
    cross-check), linked from the published index.
    - notes/parts-owned.md: the owned Orbiter V2.5's motor is an LDO 36STH20
    (model has a 36STH17; 18 mm standoffs per the O2S manual, see #121);
    1 Nitehawk-36 found, not in the design; 1 LDO LCP300-24D5 PSU, role open
    (#22).
2026-11-10 Licensing: GPL-3.0-or-later for our own work, REUSE labels on every file (vt350#122 phase 1) (#130)
    Owner decision 2026-11-10 (vt350#122): our own work (code, configs, notes, CAD
    data, our own designs) is GPL-3.0-or-later; third-party parts and our remixes
    of them keep their upstream licences. No files move in this phase.
    - LICENSE: GPL-3.0 text (was MIT). LICENSES/ holds every licence text used.
    - REUSE.toml labels all 316 files: the repo default first, then one override
    per third-party or derived folder (GPL-3.0-only for Voron, MadMax,
    andrewmcgr, clicky-clack; CC-BY-NC-SA-4.0 for A4Tv2, LDO Monolith, and our
    duct remix).
    - cad/data/fasteners/keep/*.brep: copied from the original ST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
    [manifest.csv]
2026-11-10 Licensing: the kept fastener solids are the owner's own work (vt350#122) (#131)
    The solids in cad/data/fasteners/keep/ come from the owner's own Fusion
    project (the original STEP frame with its fasteners; the rest were later
    replaced with Fasteners-workbench parts). #130 labelled them
    LicenseRef-provenance-unverified because their source wasn't recorded; the
    owner has now recorded it (2026-11-10). They fall under the repo default,
    GPL-3.0-or-later, and the custom licence text is removed.
    reuse lint: compliant, 3 licences used. check-reuse-labels: OK.
    Refs https://github.com/dvystrcil/vt350/issues/122
2026-11-10 Move the generic tools into platform/ (vt350#122 phase 2) (#132)
    The platform (tools that would work unchanged for another printer) and the
    VT350's own data are now separate folders. Dependencies point one way:
    printer code imports platform code, never the reverse.
    - platform/freecad: litelib, litepool, clashlib, contact, part_index,
    reglib, register, bezier, FCStd inspectors (+ their tests)
    - platform/render: export_meshes, render, colours, logos
    - platform/kalisim: the Kalico batch-mode image; the VT350's MCU Kconfig
    fragments move to cad/klipper/kconfig and reach the build as a named
    build context
    - platform/parts, platform/pages, platform/testing: check-printed,
    slice-check, che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
    [printer.cfg]
2026-11-10 Kalico: MadMax tool-change macros through batch mode, a pickup and a dock per head (vt350#116 AC4) (#133)
    Platform side (generic): the kalisim image fetches viesturz/klipper-toolchanger
    @94756df and copies toolchanger, tool, tool_probe and tool_probe_endstop into
    Kalico's klippy/extras/ (they import probe relatively, so not plugins/). Its
    tools_calibrate.py is left out, so Kalico keeps its own.
    VT350 side: MadMax r2pdx_config-v2-Kalico-Beacon toolchanger.cfg and
    toolchanger_macros.cfg vendored unchanged (zruncho3d/madmax@277a63c, GPL-3.0,
    blob ids checked). cad/klipper/toolchanger.cfg overrides the params_* with the
    dock positions, which dock_params.py derives from sweep_toolhead.log.
    toolc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
    [printer.cfg, toolchanger.cfg, toolchanger_macros.cfg]
2026-11-10 Kalico: Fluidd as the web front end, Mainsail a one-line switch (vt350#116) (#134)
    Platform side (generic): platform/klipper/frontends/{fluidd,mainsail}/client.cfg
    vendored unchanged (fluidd-config@807175d, mainsail-config@ff3869a, GPL-3.0,
    blob ids checked), and frontend.py, which reports which one a config includes
    and switches it (--use).
    VT350 side: cad/klipper/frontend.cfg includes Fluidd's client config (owner,
    2026-11-10). printer.cfg includes frontend.cfg in place of its own
    [virtual_sdcard], which the client config now provides. The tool changes run
    under both front ends in real Kalico and give the same timeline. Decision
    recorded in notes/status.md.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
    [client.cfg, frontend.cfg, printer.cfg]
2026-11-10 Motion player core: kalisim timeline -> model group translations, with the dock handover (vt350#135 AC1, AC2) (#136)
    Platform side (generic): platform/freecad/timeline.py turns a kalisim
    timeline plus a rig file into frames (sampled at an fps, or one per move
    end). Each frame has the printer XYZ, the head on the carriage, and every
    moving group's translation. A head couples when the carriage passes its
    docked nozzle point moving into the dock, and uncouples moving out; the
    timeline's tool field isn't used, because Kalico switches extruders before
    the pickup moves. Standard library only, no FreeCAD.
    VT350 side: cad/motion/rig.json, derived by rig.py from sweep_toolhead.log,
    xy_mapping.json a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
2026-11-10 Motion player: FreeCAD GUI player for the Kalico timeline (vt350#135 AC3) (#137)
    platform/freecad/player.py (generic): plays timeline.py's frames on the model.
    Play/pause, step back/forward, speed factor, scrub slider, Stop restores every
    Placement. It opens a private copy of the model and never saves; the copy is
    removed when the panel closes. A global translation is turned into each
    object's parent frame, so parts inside rotated App::Parts move by exactly it.
    player_gui.FCMacro starts it: FreeCAD 26.3's GUI runs an .FCMacro from its
    command line, but not a .py.
    cad/motion/play.py (VT350): runs sweep_toolhead.py's plan stage for the
    groups, names them the way rig.json does, caches them in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
2026-11-10 Motion player: clip the belts to the joint band, so they don't shoot out of the frame (vt350#135) (#139)
    Each belt is one loop from the front idlers to the rear motors (Y -83 .. 486),
    and the player moved the whole loop with the gantry. At the dock moves
    (gantry dY -263.7) its front end ended up about 264 mm past the front of the
    frame. Its side runs change length with Y, so only the part in the XY joints'
    Y band moves rigidly. That is the part the clash sweep checks
    (sweep_toolhead.BELT_CLIP).
    The groups file gets an optional "clip" {Name: global box}. The player shows
    a clipped object as a new part (the global shape's common with the box) in
    its private copy, puts it in the object's group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
2026-11-11 Motion player: hide the docks' carriage copies, the ghost carriage left in each dock (vt350#135) (#140)
    Each dock holds a copy of the carriage at its pickup pose. The plan stage
    gets the pickup offset from it, and the clash sweep leaves it out because
    the moving carriage takes its place. The player showed it, so once the
    carriage picked up a head and moved away, a second carriage stayed in the
    dock.
    sweep_toolhead.py's plan now also lists these as dock_copies (2 compounds,
    4 SpeedClips); exclude is the same set as before (the Z chain + the copies).
    The groups file gets an optional "hide" [Name], and the player hides those
    while it's open. A hidden part may not be in a moving group. play.py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
2026-11-11 Motion player: quitting FreeCAD closes the panel first, before FreeCAD asks to save the copy (vt350#135) (#141)
    Quitting FreeCAD with the player panel open asked "Save all changes to document
    '... (player copy: read-only, never saved)'?" and closed the copy's document itself.
    The panel's close then ran from the dock's visibilityChanged, after the document
    was gone: stop() and closeDocument raised ReferenceError, and only the finally
    removed the private copy.
    - An event filter on the main window closes the panel on its close event (the
    window's X, File > Exit, Ctrl+Q), before FreeCAD's own close handler.
    - shut(): a document that is already closed is not touched; the copy is always
    remov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
2026-11-11 Motion frames with the real renderer: one grouped mesh export, Blender moves the groups per frame (vt350#135 AC4) (#142)
    - platform/render/motion.py (stdlib): groups -> buckets ("<group>__<key>"), the
    frames file, per-bucket offsets, the ffmpeg command. test_motion.py, in CI.
    - export_meshes.py VT350_GROUPS: each moving group's parts in buckets of their
    own, belts cut to their clip box, the docks' carriage copies left out (the
    player's two fixes). Unset: unchanged; motion.py is imported only then, so
    the batch lane's vt350-render chain is unaffected.
    - render.py --frames: moves each group's objects by the frame's translation and
    writes frame-NNNNN.png; frames already there are skip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
2026-11-11 Tool-change docks video and T0 pickup stills from Blender; encode works on ffmpeg 9 (vt350#135 AC4, AC5) (#143)
    * Tool-change docks video and T0 pickup stills from Blender, and an encode that works on ffmpeg 9 (vt350#135 AC4, AC5)
    notes/reference/toolchange-docks.html: the 241-frame, 15 fps video of the tool-change timeline on lite-30
    (1280x720, 32 samples) and two 1920x1080, 128-sample stills at park X 21 / attach Y -68.96 (seq 20 pickup,
    seq 30 return), linked from the index and the README.
    render_frames.py encode failed on ffmpeg 9.0.2: a concat listing read from stdin resolves its entries against
    fd:, which cannot open them ("Protocol 'fd' not on whitelist"). motion.encode() now writes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
2026-11-13 slice-check: OrcaSlicer backend with the Neptune presets, now the default (gpu-batch-docker#13) (#146)
    - parts/slice/orca/: the three presets the user prints with (machine, process,
    filament), exported from the GUI with print_host blanked, plus orca.json naming
    them, the vendors to install, and the support_check overrides.
    - slice-check.py --slicer orca (default): builds a fresh Orca datadir with the
    vendors' system profiles (.opc) in system/ and the presets in user/default/<type>/,
    the only layout Orca's CLI resolves `inherits` in; reports time, grams, cost,
    per-layer time (CSV, slowest layer) and per-feature time/grams/speeds from
    --export-statistics and the G-code; keep-out bo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
2026-11-13 Frame render colour: tentative RAL 6011 (#4F7942) instead of seafoam (#101) (#147)
    colours.json frame role -> #4F7942 with the TENTATIVE note pointing at the
    DLLPDF sample (#102); README and render_full.sh text follow. A committed-map
    test pins the hex and the tentative note. AC4 (match to the physical sample)
    stays open.
2026-11-13 render: colour audit, every part no colour rule matched, in out/colour-audit.txt (vt350#91) (#148)
    export_meshes.py collects every part it asks the colour map about and writes
    colour-audit.txt: unmatched parts grouped by group path and material, with
    counts, the count on the first line. The grouping is colours.audit (pure) and
    the text colours.audit_text. It replaces the uncoloured dict, which listed only
    material Default parts and so missed e.g. the Aluminum dock crossbar of #88.
    The audit reads the full part list, not scene.json, which keeps 40 labels a
    bucket and no group per part. AC2's fixture is that part list.
    Test first: test_colours.Audit (CI) and two real-FreeCAD export tests in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
2026-11-14 Frame render colour: Prismatic RAL 6011 Dull Green #6E8C5B (vt350#101) (#150)
    The user picked Prismatic's RAL 6011 (Dull Green) at its product-photo
    centre, #6E8C5B, replacing the Fern #4F7942 stand-in. Still marked
    TENTATIVE: AC4 re-matches it to the physical sample from vt350#102.
2026-11-14 Reference page: how the frame colour was chosen (vt350#101) (#151)
    notes/reference/frame-colour.html: the Fern look next to fair renders of
    Prismatic RAL 6011 Reseda (chosen, in stock at DLLPDF) and RAL 6001
    Emerald on lite-30, each tuned so the lit frame bar matches the powder's
    product photo; the 10 closest Prismatic solid powders to Fern, measured;
    the method and sources. 12 render JPEGs (1.6 MB) in frame-colour/.
    Linked from index.html and the README table.
2026-11-14 Frame render colour: RAL 6011 render albedo #27461F (vt350#101) (#152)
    The scene's lights and paint gloss lighten colours a lot, so feeding the
    paint's photo colour #6E8C5B rendered a pale sage. #27461F is the albedo
    that makes the lit front bar render as #6E8C5B (found by test renders,
    notes/reference/frame-colour.html). The paint colour stays in the note.
    Still TENTATIVE until the vt350#102 sample (AC4).
2026-11-14 README renders: lite-30 in the chosen RAL 6011 frame colour (vt350#101) (#153)
    cad/renders/: the lite-26 seafoam JPEGs are replaced by lite-30 + ebox
    (no filter, #115) from batch-lane chain vt350-lite-30-20261114t032557-82bc,
    frame albedo #27461F. The README section names the model and chain, and
    links the frame-colour reference page.
    New check in test_render_full.py: every renders/ image the README links
    exists, and every committed render is linked (no orphans).
2026-11-14 Dock row study: spacing, tool count and safe Y for a front row of MadMax docks (vt350#19 AC2) (#154)
    cad/studies/dock_layout.py (printer side, vt350#122; read-only on lite-30): samples each
    template slot's surfaces into extent fields in freecadcmd, then a plain-python analysis
    moves them through MadMax's dock moves (6 mm keyslot slide, 5 mm detach away from the
    keyslot plate) and reports the nozzle gap between neighbours for every mix of L/R slot
    styles, the best row per tool count in the carriage's X reach, and how far behind the
    row the carried head and the empty carriage must stay.
    lite-30, 2 mm clearance: L|L 85.16, L|R 76.12, R|L 92.00, R|R 90.06. Five tools fit as
    LLRLR (329.40 of 342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
